skxmxm/handWritePen/hardware/rear_R26/warning_fit_review.md

# final23 装配件供应商属性告警独立复核

本报告只读核对 U201、D501、D502、D503。未修改嘉立创EDA、原理图或PCB。7 个 DNP 由主审另行核验。本报告不是全板 DRC 或订单批准。

**结论：上述 4 个 FIT 器件的型号、落板焊盘及 LED 极性可以得到证据支持，未发现需要重布线的封装不兼容。现存告警是库身份/属性偏差，不能表述为“原生告警已清零”。应规范器件身份和装配说明，或在发布记录中保留已核验偏差。**

## U201：ESP32-S3-MINI-1-N4R2 / C3013941

- PCB 实例型号和供应商号分别为 `ESP32-S3-MINI-1-N4R2`、`C3013941`；封装标题为 `BULETM-SMD_ESP32-S3-MINI-1-N8`。
- 本地原生公共库检索记录 `../research/module_search.json` 里，**N4R2/C3013941 本身就使用 N8 标题的封装**（公共库封装 UUID `688e78e9fb32474d8c79531d0a7cca14`，器件 UUID `41c06bb1f3f2465a9300afebb9173e5f`）。本地克隆器件映射见 `../research/mini1_device.json`。
- 乐鑫官方 `esp_mini.pdf` v1.7，§1.2/Table 1-1 明确 N8 与 N4R2 两版本仅 flash/PSRAM 配置不同。官方 §11.1/Figure 11-1（第45页）给出同一 MINI-1 推荐焊盘。因此 N8 封装名称本身并不表示装错物料。

| 焊盘项目 | 官方推荐 mm | final23 mm |
|---|---:|---:|
| 60 个外围长方形焊盘 | 0.4 × 0.8 | 0.39878 × 0.80010 |
| 四角 GND 方焊盘 | 0.8 × 0.8 | 0.80010 × 0.80010 |
| 中央 3×3 分区 GND 焊盘 | 每格 1.2 × 1.2 | 每格 1.19888 × 1.19888 |
| 中央 3×3 总跨距 | 4.5 | 4.50088 |
| 外围等距序列节距 | 0.85 | 0.84836 / 0.85090，受导出量化影响 |

实际共 73 块铜焊盘：60 个外围焊盘、4 个角部接地焊盘、中央接地端子分为9块；这与模块 65 个电气引脚并不矛盾。外围焊盘行存在约0.025 mm级与官方标注中心线的库几何差异，但落点仍在对应焊接端子区域，不属于型号 N8/N4R2 的差异。

官方 Table 3-1（第11–12页）特别规定：**N4R2 的 IO26（模块 pin 26）用于内部 PSRAM，禁止外用。** final23 的 pad 26 `eb0052c9b29dee77e102` 网络为空，未分配外部功能；不是 GPIO26 误接。USB pin23=IO19/D−、pin24=IO20/D+，当前分别接 `MCU_USB_DM` 和 `MCU_USB_DP`。

## D501–D503：LTST-C190KRKT / C94869

公共库原始检索缓存 `../../../archive/rear_ble_v0.2/led_candidate.json`（实际绝对路径见 JSON）独立确认：LITEON `LTST-C190KRKT` 对应 `C94869`，公共库器件 UUID `63e5f6cf97f041959d3d2be0d8ee7c02`。不要误选后缀 `-TH` / C284900。

实际实例属性已设为上述 Lite-On 型号，但底层器件名还保留 `19-217/R6C-AL1M2VY/3T`（Everlight）。这是真实的**库身份元数据不一致**，应整理；不能只因都是0603而笼统忽略。

使用精确型号的 Lite-On 官方 `LTST-C190KRKT.pdf`（DS-22-99-0151 Rev F，2013-05-16）进行几何核对：

| 焊盘项目 | 官方 PDF 第8页/印刷第7页 mm | final23 mm | 差值 mm |
|---|---:|---:|---:|
| 单焊盘宽×长 | 0.8 × 0.8 | 0.80010 × 0.80010 | +0.00010 |
| 两焊盘中心距 | 1.5（由2.3−0.8得到） | 1.49606 | −0.00394 |
| 两焊盘外缘总跨距 | 2.3 | 2.29616 | −0.00384 |
| 两焊盘内缘间隙 | 0.7（由2.3−2×0.8得到） | 0.69596 | −0.00404 |

上述约4 μm的量化差异不形成落板兼容问题。使用官方建议尺寸完成核验，而不是以通用封装名推断。

### 极性证据链

1. 官方 PDF 第2页/印刷第1页标注实物 `CATHODE` 端及极性，第8页/印刷第7页还标明卷带阴极方向。渲染证据 `warning_LED_p2.png`、`warning_LED_p8.png`。
2. 发布工程归档中 `SYMBOL/641f656535e2a0d7.esym` 的引脚属性明确：pin1 的 NAME=`C`，pin2 的 NAME=`A`。
3. 同一归档 `FOOTPRINT/4d57fd2c087faba9.efoo` 明确：pad1 在局部负X一侧，pad2 在局部正X一侧。该封装源 UUID `52397efb0c114c5ca131f1a452e65163` 是 Lite-On `-TH` 版本的通用 `LED0603-RD` 来源；此处已按**实际采购的无后缀型号**重新核验尺寸。
4. final23 三个器件均在顶层、rotation=0，映射如下。坐标单位 mm，为PCB数据坐标。

| 位号 | pin1/C 阴极网络 | pin2/A 阳极网络 | 阴极 X | 阳极 X |
|---|---|---|---:|---:|
| D501 | GND | LED_SYS_A | 34.25190 | 35.74796 |
| D502 | GND | LED_FAULT_A | 37.75202 | 39.24808 |
| D503 | CHG_STAT2 | LED_CHG_A | 41.25214 | 42.74820 |

因此，**顶视图三只 LED 都应阴极朝左（较小 X）、阳极朝右（较大 X）**。D503 阴极接充电芯片开漏状态 `CHG_STAT2`，由其下拉点亮。装配时以 Lite-On 数据手册标记和以上电气定义核对，不能仅凭继承的旧型号名字判断方向。

## 发布处理建议

- 可以保留已路由的焊盘几何。BOM 必须保持 U201=`ESP32-S3-MINI-1-N4R2/C3013941`；D501–503=`LTST-C190KRKT/C94869`。
- 首选清理器件库身份；若绑定标准库会改变焊盘坐标、编号或钢网开口，应保留经审核封装，并明确记录偏差，不应为消除标题告警盲目替换。
- LED 的 `Review` 目前仍含 `Engineering draft; MPN and footprint require review`，应更新为已核验记录，避免与发布结论矛盾。
- SMT 装配说明必须明确三个 LED 的阴极方向。CPL 数值角度还须由主审与厂家贴片坐标约定核对；不能仅由 rotation=0推断供料朝向。
- 若主审规范了元数据或重新绑定库，继续导出 BOM/CPL 并核对 pad identity、原理图网络、铜层/钢网；本报告不声称修改后检查已完成。

审查输入：`final23_pcb.json` SHA-256 `add49678d7fddc966dc4f3cfcc579124299e275c2b622c8afa2d397cdd9152c0`。结构化结果、完整证据路径见 `warning_fit_review.json`。
