skxmxm/handWritePen/hardware/rear_R26/下单与耗材说明.md

# R26 裸板＋钢网，自行焊接下单说明

> **同日降本补充：**下面9孔填孔盖帽参数是R26原文件的保守制造基线，不等于9孔都不可取消。逐孔复查为8处普通阻容＋1处无贴件测试焊盘；推荐局部移孔后改普通工艺，详见[盘中孔降本评估](盘中孔降本评估.md)。当前未改PCB，不应仅切换订单选项就把本包视为已验证的低成本版本。

更新：2026-10-12。用户选择不购买SMT代工，已有热风枪、烙铁和加热台。本说明仅改变采购与装配方式；在线PCB、板框、网络及R26 Gerber没有改动。未登录代下单、未上传工程、未购买任何物品。

## 先用哪些文件

- 嘉立创PCB下单上传 `后板_R26_制板文件.zip`，不要上传外面这个指南压缩包或旧PCB＋SMT全套包。
- 嘉立创钢网独立下单上传 `后板_R26_钢网原始层.zip`。包括原始GTP、GBP、板框、双面装配和丝印参考。真正开孔依据GTP/GBP，不能拿阻焊层GTS/GBS开钢网。
- `VIA_IN_PAD_PROCESS.csv` 是当前9个盘中孔的坐标清单，作为PCB备注附件。
- `BOM_FIT_REVIEW.csv` 是一块板112个实装器件的采购基线，不是向工厂提交SMT委托。表内“Automatic SMT”是历史装配分类，本次全部自行装配；U401/J301依然最后后焊。
- 8件DNP和3组PCB_ONLY按 `DNP_PCB_ONLY_REVIEW.csv` 排除，不按焊盘数量购物。

## 1. 下裸板订单

在[嘉立创官网](https://www.jlc.com/)进入PCB计价/下单，上传制板ZIP；也可在嘉立创EDA选择PCB下单入口。页面标题随版本可能变化，以以下工艺值为准。

| 项目 | 本板填写 |
|---|---|
| 服务 | PCB裸板，不选择SMT贴片、代购代贴 |
| 材料/层数 | FR4 / 4层 |
| 单片尺寸 | 70×24 mm |
| 成品厚度 | 1.00 mm，常规±10% |
| 数量 | 建议先做5片，实际按平台起订数和报价决定；先装1片验证 |
| 拼板 | 单片出货；本次手工装配先不另做拼板/工艺边 |
| 铜厚 | 外层1 oz、内层0.5 oz |
| 阻焊/丝印 | 绿色阻焊、白色丝印 |
| 表面处理 | 沉金ENIG |
| 叠层 | 指定JLC04101H-3313；不能默换7628 |
| 阻抗 | USB差分90 Ω±10%，L1参考L2 GND，主干W/S=0.15/0.15 mm |
| 盘中孔 | 指定9孔树脂填孔、整平、电镀盖帽；普通盖油/塞油不能替代 |
| 其它 | 保留8个PTH金属槽、3个NPTH孔；全板231个过孔 |

小板尺寸不能代替特殊工艺报价。四层、沉金、阻抗及填孔盖帽可能不适用普通免费打样活动，费用以网站和工程审核为准。如果页面只能整板处理过孔，可按全部231个过孔询价，8个连接器槽和3个非金属孔不得填堵。只需裸板也仍然需要这9处盘中孔工艺。

PCB备注可复制：

> R26手写笔后板，单片70×24 mm，四层FR4、1.00 mm，外层1 oz/内层0.5 oz，绿油白字、沉金。指定JLC04101H-3313，USB L1差分90 Ω±10%、L2 GND参考，主干线宽/线距0.15/0.15 mm。附件VIA_IN_PAD_PROCESS.csv的9个盘中孔要求树脂填孔、整平、电镀铜盖帽，器件焊盘开窗保持可焊；不能用盖油或塞油替代。保留8个金属化槽、3个NPTH孔。只制裸板，不委托SMT。J401引脚文字高0.85 mm，请工程确认能否完整清晰印刷；不能处理时请反馈工程稿，不要静默裁掉关键脚号。

**丝印需确认：**本次重新对照官网发现，J401五个引脚文字0.85 mm低于公开常规字符高度≥1 mm；标题为1 mm，普通位号1.1 mm。此前“丝印无重叠”的检查只证明间距，不等于符合所有印刷工艺要求。铜层、焊盘及网络不因此改变，但不能保证小字印刷质量。板厂若拒绝这一字高，应先单独修正丝印并重新导出，再提交生产，不能把旧版DRC=0当成厂方工艺确认。

注意：旧包《嘉立创工艺核实》中的13孔、223孔数字属于D3历史，当前必须用随包9孔CSV与231孔钻孔文件。

## 2. 单独开钢网

官方[钢网下单](https://www.jlc-gw.com/quote-online/steelmesh)可以独立下单，无须委托SMT。

| 项目 | 本次建议 |
|---|---|
| 类型 | SMT钢片（不带框），适合无印刷机的手工定位；若后续买印刷架，再按架子规格选带框 |
| 工艺/用途 | 激光切割、锡膏网；不选红胶网 |
| 面别 | 顶层和底层分开，2张，总计一套 |
| 厚度 | 顶面0.08 mm；底面0.10 mm |
| 抛光 | 电解抛光；纳米涂层可选，不是本次必需项 |
| 成品钢片长宽 | 选能容纳70×24 mm图形且四周留出刮刀行程/胶带固定区的规格；不能把成品钢片也做成70×24 mm。以平台可选尺寸和手工夹具匹配 |
| MARK | 无自动印刷机，可不增加MARK通孔；现有孔/外框辅助定位 |
| 工程稿 | 选择“需要确认PDF档”，核对后再切割 |
| 方向 | 文件是原始工程坐标，未预镜像。由钢网厂按实际印刷面处理底层方向；自己不再镜像一次 |

若网页的“顶底分开”只能填同一厚度，将顶面、底面各建一条钢片订单，并在备注写明同一R26板的TOP/BOTTOM。不要为省一个订单而默认两面0.12 mm。官方还支持顶底合开一张，若日后想用同一厚度合开，必须先重新确认最小孔脱模，不按当前推荐直接合并。

厚度建议来自原始锡膏层几何，不是随口选值：

| 位置 | 原始最小开口 | 0.12 mm面积比 | 0.10 mm面积比 | 0.08 mm面积比 |
|---|---|---:|---:|---:|
| 顶面U103，3个开口 | 约0.30×0.20 mm | 0.500 | 0.600 | 0.750 |
| 底面U101，10个引脚 | 约0.50×0.20 mm | 0.595 | 0.714 | 0.893 |

面积比=开口面积/(开口周长×钢片厚度)，约0.66是常用脱模筛查参考值，不能代替实际锡膏转印试验。旧文件的0.12 mm只是默认工厂评审输入，本次手工印刷建议以此表更新为顶0.08、底0.10。顶面薄钢片减少大焊盘锡膏体积，需钢网厂同时复核ESP32等大焊盘锡量及分窗；若要改开口，应提供工程PDF并说明变动，不自动整层缩孔。

钢网备注可复制：

> R26后板，单片70×24 mm，手工印刷。顶面0.08 mm、底面0.10 mm，两张无框锡膏钢片，激光切割、电解抛光。以GTP/GBP为原始锡膏层，不使用阻焊层生成；文件未预镜像，请按实际顶/底印刷方向制作并标TOP/BOTTOM。保留DNP和PCB_ONLY不开孔的现状。U101散热焊盘、ESP32模块底部焊盘按原有分窗作为审核基线；请复核脱模和锡量，任何缩孔/分窗调整先给PDF确认。U401 JY901S为后焊模块，其锡膏开口是预镀锡用途，不得因“非常规元件”而静默删除。请标R26/TOP/BOTTOM及厚度。

## 3. 在立创商城买哪些耗材

到[立创商城](https://www.szlcsc.com/)按下表关键词搜索即可。这里给采购规格，不冒充已查到库存/价格，也不随意指定未经核实的商品编号。

| 耗材 | 搜索词/规格 | 首批建议 |
|---|---|---|
| 锡膏 | SAC305 无铅锡膏 T4 小包装，正规品牌、有储存说明和回流曲线；手工刮印优先选适合钢网印刷的型号 | 10～20 g一份，细间距用T4 |
| 助焊剂 | 电子焊接用低残留助焊膏/助焊剂，兼容所选锡膏，可清洗 | 1支小包装 |
| 焊锡丝 | SAC305无铅焊锡丝，直径0.3～0.5 mm，用于接口和补焊 | 1小卷 |
| 吸锡带 | 1～1.5 mm细吸锡编织带 | 1卷 |
| 钢网刮刀 | 约80～100 mm有效刃宽、直边、适合小钢网 | 1把 |
| 清洗耗材 | 与助焊剂兼容的电子清洗剂；可用IPA的型号配高纯异丙醇、无尘布、无尘棉签、ESD刷 | 各1份 |
| 定位/遮挡 | 聚酰亚胺耐高温胶带、同厚度垫板或可调PCB定位夹具 | 各1份 |
| 拾取 | 精细防静电镊子，直头＋弯头 | 已有则不买 |
| 双面支撑 | 耐高温PCB边缘支架/悬空夹具；底下留出器件净空 | 1套，避免器件压在热台上 |
| 检查/测温 | 显微镜或足够倍率放大镜、K型细热电偶温度计 | 已有则不买；屏幕设定温度不等于焊点温度 |

本板底部焊盘/细间距不能靠普通烙铁逐脚完成。已有热风枪＋加热台可做预热与局部回流，但仍需控制实际温度、风量和焊点锡量。优先常规SAC305，不把138℃铋系低温锡膏当作可随意替换的省事方案；换合金会改变回流与机械可靠性，需另做工艺验证。

锡膏按产品说明冷藏、密封回温后开盖，查看有效期；不把统一的热风枪显示温度当成回流曲线。不使用水暖焊接酸性助焊剂。GSR模拟前端对残留敏感，补焊后按药剂说明局部清洁并干燥；不要给JY901S整模块浸泡或超声清洗。

## 4. 元器件与自焊顺序

耗材不包含器件。按BOM_FIT_REVIEW中的制造商料号和容差单独采购，默认一板112件，8个DNP不装。常用阻容多备一些；昂贵芯片按计划装板数外加适量备件。不要把库中Supplier Part字段一概视为立创有现货，尤其JY901S仍应按已选裸模块向原供应商采购。

必须保留ESP32-S3-MINI-1-N4R2、BQ25185DLHR、TPS63802DLAR、R111/R112的精度与温漂、正确LED料号；不能凭历史封装名或同阻值自动替料。前端PAT9125EL-TKIT仍购买成品，不下历史自制前板。

建议先装1块：底面细小器件先印刷/回流，检查短路；再将板固定在悬空夹具上装顶面。已焊底面不能与热台直接接触；对齐第二面钢网也需要避让底面器件的支撑。第二次加热要避免下侧焊点重新熔化导致掉件，尽量以底部适当预热配合顶部局部热风，并按实际测温/器件耐温控制。ESP32的底部地焊盘需要按钢网回流，不能只补四周可见边缘。

顶底回流完成后，最后安装U401 JY901S和J301指套插座。USB连接器的金属化壳脚槽按实际润湿状态补焊；用限流电源先测短路、3V45、充电/USB/主控通信，再接传感器。普通显微镜无法直接检查藏在芯片下面的焊点，一次外观检查不能保证隐藏焊点全部良好。

## 官方依据与本轮限制

2026-10-12读取：

- [嘉立创PCB工艺能力](https://www.jlc.com/portal/vtechnology.html)：字符常规高度≥1 mm、线宽≥0.1 mm、距露铜≥0.15 mm，以及盘中孔工艺范围。
- [嘉立创钢网下单页](https://www.jlc-gw.com/quote-online/steelmesh)：无框钢片、顶底合开/分开、锡膏网、电解抛光、工程PDF确认及底层镜像说明。页面建议≤0.5 mm间距选电解抛光。
- [嘉立创EDA PCB下单说明](https://prodocs.lceda.cn/cn/pcb/order-order-pcb/index.html)。

锡膏层原始文件完全未变；厚度几何核算详见《钢网厚度几何核对.json》。本说明没有确认商城即时库存或订单实际价格，也没有提交制造订单。J401小字印刷与钢网开口/锡量审核仍需在工程稿落实。
