skxmxm/handWritePen/hardware/rear_R26/关键布局复核与首件重点.md

# R26 关键布局复核与首件重点

## 已重查

- 电源：开关节点短宽直连，主要电容和功率地/控制地按实际铜连接复核；一般供电主干原线宽保留。USB_RAW、USB_5V与3V45冗余台阶已整理。
- 模拟：GSR_S重复小环路已去掉；高阻节点远离主开关区域。J302调试支路保留，其长度不应全算成主采样通路。
- USB：全程顶层，实际L2 GND覆盖全线宽；主干W/S=0.15/0.15 mm，指定3313叠层。不能用任意默认叠层替代。端部ESD/焊盘扇出与分支不是均匀传输线；本次未做眼图。
- RF/IMU：实际四铜层的9个禁区均无铜；天线悬出及组装约75 mm总包络未改变。
- 可装配性：全部112实装封装外形检查，无同侧重叠，最近外形间隙0.475 mm。原生deviceClearance=0意味着不能靠DRC证明这件事，故本轮另行计算。

## 保留折衷

C101至BQ25185输入约3.8 mm/2过孔，优于无输入去耦但不是理想贴脚；R111高端反馈从共享3V45支路取样，约8.759 mm/2过孔（以本包final_critical_paths_usb.json的最终中心线路径为准），不属于独立Kelvin。本轮保持关键电源器件、接口与板框，并只疏开周边器件时，没有用穿越其它焊盘或减少净距换取外观。未见原厂给出这些长度的硬性数值门槛，故列为首件关注项而非伪称已全部理想化。

电容地回流按实际连续铜和内层地判断，不能只用最近过孔的距离代替回流路径。供电最窄段和电池瞬态需要结合真实BLE负载验证，几何检查不等于负载阶跃仿真。

## 首件重点

按既有《上电验证与放行清单》进行：受控电源限流启动、3V45带载及BLE峰值瞬态、充电与NTC、USB烧录、AFE标准电阻校准和底噪、JY901S/PAT9125接口、装壳射频与续航。新电池的正式连续/脉冲电流能力仍待型号资料和实测确认。未下单。
