skxmxm/handWritePen/hardware/rear_R26/嘉立创工艺核实.md

# 嘉立创盘中孔工艺核实

查询日期：2026-10-05。仅查询官方公开资料，未上传工程、询价或下单；PCB电路及几何未改。

## 结论

嘉立创明确支持本板所需的 **过孔塞树脂＋电镀盖帽（盘中孔）**。四层板支持，官方指引注明收费；具体费用与交期以订单实时报价为准。不能继续把“厂商是否有此能力”列为未知阻碍。

| 对照项 | 嘉立创官方规则 | D3情况 |
|---|---|---|
| 工艺效果 | 树脂填平过孔后表面镀铜；盖帽铜厚≥10µm；开窗处可以焊接 | 符合原要求的填实、平整、可焊铜帽结构 |
| 支持孔径 | 0.15～0.55mm | 两类过孔钻孔约0.20828/0.210mm，范围内 |
| 外径与内径差 | 至少0.1mm，推荐≥0.15mm | 约0.24384/0.240mm，满足 |
| 盘中孔位置 | 位于焊盘中心或边上均属于盘中孔 | 13处孔口与器件开窗相交，适用 |
| 层数及厚度 | 四层收费；FR4公开厚度范围0.4～4.8mm，以系统选项为准 | 四层、候选1.0mm在公开能力范围内；具体组合及叠层仍按订单确认 |
| 指定加工范围 | 可标示哪些过孔塞住，或按孔径备注 | 可提供13孔坐标清单；不必假定只能全板223孔加工 |

上述网页没有明确给出IPC-4761 Type VII认证承诺或完整凹凸公差。原文档的“Type VII等效”是工艺结构描述，不能写成板厂已认证。

## 下单工艺说明

选择 **过孔塞树脂＋电镀盖帽**，不要用“过孔盖油”或“过孔塞油”替代。建议备注如下：

> 四层FR4后板，70×24mm，目标厚度1.0mm，沉金。附件VIA_IN_PAD_PROCESS.csv列出的13个过孔要求树脂填实、平整、电镀铜盖帽≥10µm，器件焊盘开窗处保持可焊；不得用盖油或半塞油替代。请在生产稿中确认这些孔按盘中孔加工，保留器件焊盘开窗。孔径以最终Gerber/钻孔为准。其余过孔是否同时处理及费用，以订单工艺确认为准。

如采用整板同孔径加工，必须保留8个金属化连接器槽和3个非金属定位孔，不能把它们塞住。下单生产稿需核对塞孔范围、阻焊和层叠；这是订单执行核对，不是厂商能力未知。

## 原D3差距与D4处理

官方FR4规则为字符高度≥1mm、笔画≥0.1mm、字符到露铜焊盘间隙≥0.15mm。D3用途文字主要0.8～0.9mm，部分脚号0.65～0.75mm；0.12mm笔画满足要求，但字高不足。D3原CAM仅做0.1mm开窗避让，零重叠不能证明满足0.15mm露铜间距。**D4已修正：保留122处文字的设计字高1.1mm、笔画0.12mm；全部丝印至开窗最小约0.1699mm，文字图形最小约0.2009mm，没有文字被裁切；12个位号转装配层并附定位图。** 这些是制造文件检查，实物印刷效果尚未测量。

## 官方来源

1. [嘉立创工艺能力](https://www.jlc.com/portal/vtechnology.html)：当前公开工艺、0.15～0.55mm孔径、铜帽≥10µm及字符规则。
2. [盘中孔设计指引及规则](https://www.jlc.com/portal/q33i38630.html)：2022-10-19，明确四层收费、焊盘边孔适用及孔盘尺寸。
3. [过孔五种加工方式](https://www.jlc.com/portal/server_guide_15544.html)：页面显示更新2026-09-30，说明树脂填平后表面镀铜及按孔位/孔径指定加工。

网页快照、提取文本、URL及SHA256保存在 [官方证据目录](via_process_evidence/sources.json)。公开工艺核实不替代电池、电源及首件功能验证。
