skxmxm/handWritePen/hardware/rear_R26/本版说明.md

# R26 底面布局与接口丝印优化版

2026-10-09。原在线工程已保存，70×24 mm、四层1.00 mm，ESP32-S3-MINI-1-N4R2 / BLE。本包用于首批PCB＋SMT工程样板，交厂DFM与贴装预览核对；未下单。

## 已完成

- 疏开接口区、状态电路及模拟区的11个底面器件，其中8件实装、3件DNP；移动1个BAT_DIV过孔。接口、板框、主控、原理图和电气网络保持。
- C302与U301本体间隙由0.30提高到0.50 mm；R301与R312焊盘间隙约0.163提高到0.362 mm。R503与C107本体间隙0.875→1.875 mm；R510与R502间隙1.05→2.10 mm。
- 局部走线按直线/45°重新组织，清理短碎段与两处保存时的近共线合并。新增1个盖油接地过孔和2条直线，接通新布局中的前端固定焊盘地铜。最终1664线、231过孔；不能将线段减少量等同于肉眼可见转弯减少量。
- J401 OPT和五条1 VDD / 2 SCL / 3 SDA / 4 MOT / 5 GND紧邻实际接口，按对应焊盘排列；旧远端表格已删除。55个底面位号全部保留，调整28个位置/方向。实验室名称保留。

## 同版验证

- 原生PCB DRC=0，实际四层Gerber的77个有名网全部单一连通，短路、断网、浮铜和缺失焊盘中心均为0。
- 418个焊盘铜/阻焊/适用锡膏通过；USB全程顶层、无信号孔、L2参考地覆盖全线宽；9处禁布区无铜侵入。
- 自由直角/锐角0；32个焊盘/过孔/真实分支交汇另行归类。保留合理的短直连与原始量化微斜线，不声称全板每个原始片段数学严格45°。
- 112件实装外形无同面重叠，最小间隙0.475 mm；跨器件焊盘无重叠，最小间距0.21717 mm。
- 126条文字、158个内嵌封装丝印、POLY/FILL完整本体检查无冲突。实际丝印到开窗最小间隙顶面0.171978 mm、底面0.171984 mm；未经CAM裁切。
- 5页原理图电路记录不变，65符号/38封装齐全；38封装与R25逐字节相同。原生/API/EPRO中1664线、231孔、123器件逐对象一致。182个网络/层的铜形与批准候选按2 nm保存精度一致，无例外。
- 110件SMT和112件总装CPL各更新8件实装位置/方向，3件DNP的位置在工程与变更表中记录；BOM不变。全部现版CPL重新逐项核对。

## 制造与实物验证

保持指定3313叠层、USB 90Ω±10%、9处盘中孔树脂填孔/整平/电镀盖帽；新增GND孔为盖油孔，未增加盘中孔数量。110件SMT＋U401/J301共2件回流后手焊。

C101输入去耦跨层、R111共享电源支路取样等既有折衷仍列在《关键布局复核与首件重点》。本轮是设计与制造数据检查，首件上电、充电、BLE峰值、AFE噪声、真实电池续航及装壳适配仍需实测。

## 文件

- Rear_ESP32S3_R26.epro：完整可编辑原理图和PCB工程。只制造Rear_Mainboard，历史Front_Optical不制造。
- 后板_R26_制板文件.zip：18个原生文件，只剔除已证明重复的via-only钻孔文件。
- cam_top.png / cam_bottom.png：实际制造图；final_bottom_before_after.png为实际底面前后对照。
- R26装配说明.md和本版CPL为现行位置；旧R23 PDF仅用于器件识别和工序参考。
- R26本次核验为当前证据；R23/R24目录为历史依据。MANIFEST_SHA256.json核对文件完整性。
