skxmxm/handWritePen/software/PenLive/验证记录.md

# v0.61 启动灯光验证记录

2026-11-05。用户确认纯电池失败状态短按RESET可恢复；本版加入启动阶段显示，没有证明冷启动故障已修复。

- **实际Arduino编译通过**：本机3.2.1-cn板包，ESP32S3 Dev Module、Hardware CDC/JTAG、4MB、QSPI PSRAM、Huge APP；程序970,946字节，静态RAM49,292字节。日志 `reports/arduino_compile_v061.log`。
- **新增启动状态机C++测试通过**：初始化未完成保持双灯常亮；完成后灭250ms/亮250ms，同步10周期、逻辑计时5,000ms；正常灯态不抢占启动灯；结束后正确交还SYS/FAULT；32位毫秒回绕正确。日志 `reports/startup_lights_test.log`。物理闪烁的调度误差未实测。
- **底层API核对**：本机Arduino-ESP32 3.2.1-cn的esp32-hal-gpio.c要求pinMode注册后才能digitalWrite，已改为预置锁存→pinMode→digitalWrite。没有将此问题作为冷启动原因的已确认结论。
- **并发/激励核对**：setup先点亮两灯；任务只提交正常灯态，由主循环独占运行时LED输出。两个采集服务完成首轮结果后才闪灯；闪烁结束才广播/允许订阅；启动阶段GSR保持关闭，USB联锁、门限和状态机未改。
- **范围与兼容**：现有Python源文件及固件既有头文件共33份与v0.60哈希一致，新增StartupLights.h。v4传输协议不变，v0.60上位机可继续用；本轮无需重复UI/吞吐测试，下方80项Python等为v0.60历史结果。源文件比对和本轮验证摘要见 `reports/startup_validation_v061.json`。

闪灯表示应用的初始化流程已完成首次处理，不代表每个传感器健康。缺失传感器会在进入正常模式后通过FAULT及上位机反馈。队列/任务创建失败时SYS灭、FAULT常亮，激励关闭。若应用之前就卡在供电、ROM或复位阶段，软件无法点灯；本版没有自动重启或绕过保护。

本轮未烧录、未实物测试LED、首次电池启动或供电波形。交付前核验ZIP的CRC、文件内容、哈希与启动脚本执行权限；v0.60完整包已归档。当前源码/文档版本见 `reports/release_sha256.json`，本次压缩包校验在output目录的 `手写笔_R26_BLE_v061_包校验.json`。

---

以下为v0.60历史验证，性能、窗口截图和测试次数均对应那一版；本版仅通过上述未改文件核对复用兼容性结论。

# v0.60 验证记录

日期：2026-11-05。用户报告换板后恢复正常；怀疑电容损坏，未独立确认。此次是软件升级，不把换板反馈当作新版本实测。

## 已完成

- **Arduino实编译通过**：ESP32核心3.2.1、ESP32S3 Dev Module、4MB、QSPI PSRAM、Huge APP、Hardware CDC/JTAG。程序970,542字节，静态RAM49,284字节。日志 `reports/arduino_compile.log`；未上传。
- **80项Python测试通过**：v2/v3兼容、v4持续GSR/姿态、USB暂停、分通道时间与序号、抬笔/落笔/丢包缺口、超时/重启、CRC/所有分片长度、BLE订阅失败/队列溢出、原始与滤波切换、频率统计。日志 `reports/python_tests.log`。
- **5组C++本地测试通过**：位置累积、激励门控、ADS1115转换对、JY901S解析、电池窗口。激励状态机覆盖连续请求、USB/取消请求、上下界、ADC错误、超时和毫秒计数回绕。日志 `reports/native_tests.log`。
- **C++→Python光学协议核对通过**：真实打包结构生成3点样本，包含32位序号回绕、64位时间、负坐标和松开标志；由Python解码核验。`reports/cpp_optical.hex`。旧协议fixture保留用于兼容回归。
- **5组真实Tk功能检查通过**：三窗口联动、新v4双通道/滤波/USB暂停/独立清空、旧v3抬笔移动、增量渲染、旧无激励模式兼容。包括按钮、剪贴板、画布缺口和窗口内控件布局。`reports/gui_tests.log`。

## 模拟吞吐与界面结果

5秒本机模拟：200Hz轨迹点、50批/秒、25Hz遥测，经过真实协议解码、后台生产者、事件队列、实际Tk绘图，预载18,000个历史点。窗口预热500ms后测量。启用默认轻度平滑。

| 指标 | 本次测量 |
|---|---:|
| 设备计数推算的模拟采集率 | 200.0 Hz |
| 轨迹接收 | 200.0 点/秒 |
| 主遥测接收 | 25.0 包/秒 |
| 应用数据吞吐 | 8524.81 B/s |
| 界面调度 | 59.88 次/秒 |
| 队列等待P95 | 21.24 ms |
| 队列等待最大 | 28.76 ms |
| 接收点 / 产生点 | 1000 / 1000 |
| 序号缺口 / 过期丢弃 / 剩余队列 | 0 / 0 / 0 |

这是合成数据通过桌面软件的结果，**未测试真实BLE射频、传感器200Hz能力、人体GSR、实物延迟或显示器VSYNC**。具体结果见 `reports/continuous_refresh.json`，脚本可复现。调整期间发现每帧强制 `update_idletasks` 会将本机UI降至约30次/秒，取消后恢复约60；并发窗口启动未预热的一次试跑发生过期丢弃，未作为性能合格结果，最终测试明确预热范围。负载过重或后台运行仍可能降低频率，程序保留丢弃计数。

## 平滑边界

采用确定随机种子的1000点合成静止噪声，轻度模式RMS小于原始55%；1000计数/秒合成匀速段延迟小于7计数（约7ms），拐角不越过输入坐标包络，松开端点回到原始值，断笔后滤波状态重置。这些是算法测试，不是传感器实测降噪百分比。关闭平滑时保持输入点一致。

## 待实板验证

需要用户同时烧录固件、启动配套Python：确认电池供电＋BLE连接但不按微动时GSR/姿态持续显示，USB接入暂停激励；检查界面实测采集/接收/丢弃数、连续写字、长时间运行及续航。JY901S输出率/波特率由实际模块设置决定，本次未写入模块配置。ADC A0/A1非同时采样；统一软件时间戳不等于已验证物理同步。

截图 `reports/v060_window_0_模拟.png`、`v060_window_1_模拟.png`、`v060_window_2_模拟.png` 来自本版本实际窗口，模拟抬笔状态且持续姿态/GSR。文件哈希在 `reports/release_sha256.json`，包校验另见output目录。旧验证记录归档于 `reports/history/截至v059的验证记录.md`，不代表当前版本默认行为。
