skxmxm/handWritePen/hardware/rear_R26/原理图警告处理.md

# R23 原理图警告与日志处理

原生严格原理图检查：**0 error、1 warning**；PCB严格DRC为0。这里记录保留的已审核工程偏差，不把软件告警说成清零。

原先另一条警告来自后板图页4中已禁用BOM/PCB转换的PAT9125参考器件U1，8脚完全悬空。已备份后删除该参考对象，改为“采购光学模块经J401接入”的文字。后板418焊盘与新导出网表仍全部一致，独立前板历史工程未动。

保留提醒为“元件的属性与供应商编号不匹配”，涉及11个位号：

|位号|已核对的原因与处理|
|---|---|
|C104、R105、R319、R408、R409、R410、C405|7个DNP使用NO_PASTE自定义封装；铜/孔几何与原库完全保持，原生钢网无开口。保留自定义库，不能自动标准化恢复锡膏。|
|U201|C3013941明确为ESP32-S3-MINI-1-N4R2；供应商库本身沿用N8封装名。焊盘兼容，内部PSRAM占用的IO26未外用。采购必须N4R2。|
|D501/D502/D503|精确物料为Lite-On LTST-C190KRKT/C94869；旧底层器件名及Review字段来自Everlight工程草稿。已按Lite-On原厂推荐焊盘与阴极标记重新核验；将该元数据差异作为有记录的偏差接受。旧Review字段由本报告覆盖，不作为采购或待审状态依据。|

**三只LED顶视图均阴极朝左（较小X，pad1），阳极朝右（pad2）**。机器供料角度在工厂贴装预览中核对。不得按继承的Everlight名字或-TH后缀替换BOM。当前制造BOM/CPL采用精确料号、位置、面和转角，没有按旧底层名称采购。

证据：`warning_fit_review.md/.json`、`final23_schematic_disposition.json`、`final23_netlist_check.json`及418焊盘/原生导出验证。这个有记录的库偏差不要求重新布线；若以后重绑标准器件库，应重新核对编号、铜、钢网和BOM/CPL。

截图中的6条“格式错误”位于应用日志，最晚为2026-10-07 20:04:45；各条没有具体对象或失败操作，历史触发原因不能仅凭文字确定。最新保存、工程/网表导出未新增此错误，当前EPRO/在线源/418焊盘/实际CAM已交叉核对。原日志保留，没有清空日志来制造零错表象。记录见`final23_log_review.json`。

交付状态限定为**首批工程样板的PCB＋SMT文件**；厂方DFM、备料与机台预览按工艺说明核对，实物上电、真实电池适配和整机性能仍按首件清单实测。未下单。
