skxmxm/handWritePen/hardware/rear_R26/盘中孔降本评估.md

# 盘中孔工艺降本复核

2026-10-12。只评估，不改变PCB、Gerber或下单。

## 修正先前结论

R26旧制造基线把所有与器件/测试焊盘阻焊开窗相交的9个过孔统一列为填孔盖帽对象。这是一种保守制造选择，不能直接推导成“全部9孔在任何装配方式下都必须做这个工艺”。此前回复表述过强。

逐孔核对发现：

| 位置 | 装配用途 | 降本考虑 |
|---|---|---|
| R113.1、R505.2、R102.2、R109.2 | 实装电阻焊盘 | 优先移出焊盘并补短走线；原位开孔手焊可尝试，但有吸锡/焊点不均风险 |
| C206.2、C107.1、C106.1、C105.1 | 实装电容焊盘，其中两孔在边缘部分相交 | 优先局部移孔；电源电容处须保持低阻抗、短回路及跨层连接，不能随意远移或删孔 |
| J302.3 / GSR_S | PCB_ONLY测试焊盘，不贴器件、无锡膏 | 通常无需填孔盖帽；按探针/焊飞线用途确认是否需要平面接触 |

这些孔不是隐藏于BQ25185/TPS63802等细间距IC底部的焊盘孔。普通阻容焊盘上的开孔并不必然导致整板失败，但焊锡可能流入孔中，造成锡量不足、两端不平衡及补焊；不能将这种人工可补救的试验装配等同已验证的量产工艺。

## 可选路线

1. **推荐：局部改版消除贴装盘中孔。** 保持电路功能，目标保持现有板框和接口位置，移出8个实装焊盘里的孔、局部重布线，并检查焊盘与孔间阻焊隔离、全层间距、回流、连通、钢网和丝印。确认普通过孔工艺适用后再导出新的制造版本。此时可用普通过孔盖油/符合板厂规则的塞油，省去树脂填孔盖帽。本次尚未完成移孔可行性和走线验证，不能把R26原包直接当成降本版。
2. **原位开孔做手焊试验。** 对这些普通阻容而言不是绝对不可焊，但需要逐处检查/补焊；开窗本身不阻止吸锡，全板统一开窗还会额外露铜。不是争取低返工率的首选，不作为未经首件验证的默认替代。
3. **直接改塞油并不等价。** 普通阻焊油墨不是可焊铜帽；在焊盘开窗内可能只能部分塞孔，也可能占去可焊表面。不得允许工厂为塞油整块遮住元件焊盘，必须看生产稿。所谓“选了塞油”不能保证原有盘中孔被填平且可焊。

电镀盖帽是局部焊盘孔的工艺需求，不是ESP32主控的固定要求。低成本方向应先优化孔位，而不是依赖未经验证的下单选项替换。

依据：[嘉立创过孔五种加工方式](https://www.jlc.com/portal/server_guide_15544.html)（项目已保存的官方资料说明：部分孔在开窗焊盘上时，塞油可能只能半塞；塞油表面不沾锡，树脂填平后镀铜才恢复可焊表面）。逐孔数据见《盘中孔成本复核.json》。历史9孔CSV保留作为R26原始基线，不代表推荐继续购买高价9孔工艺。
