skxmxm/handWritePen/hardware/rear_R26/cam_bottom.png

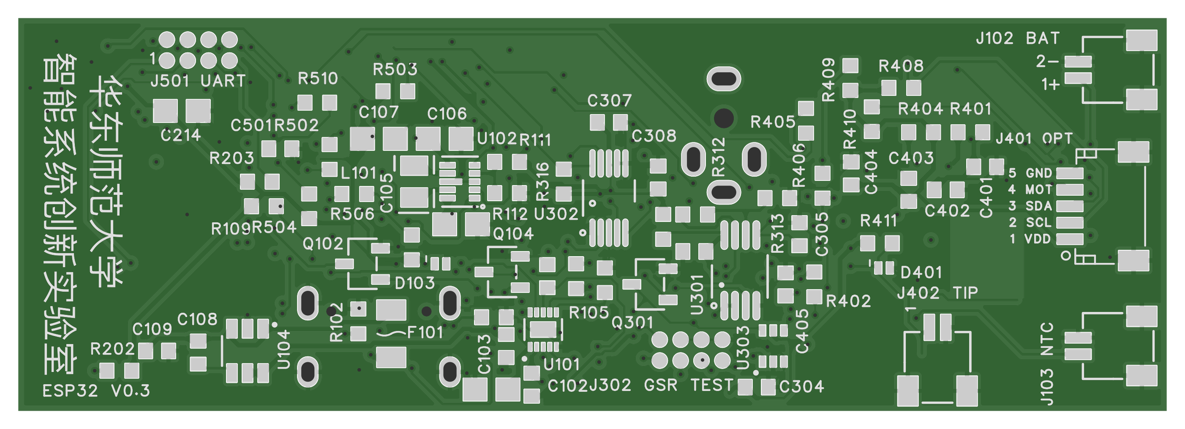
hardware/rear_R26/cam_bottom.png
