skxmxm/handWritePen/hardware/rear_R26/cam_top.png

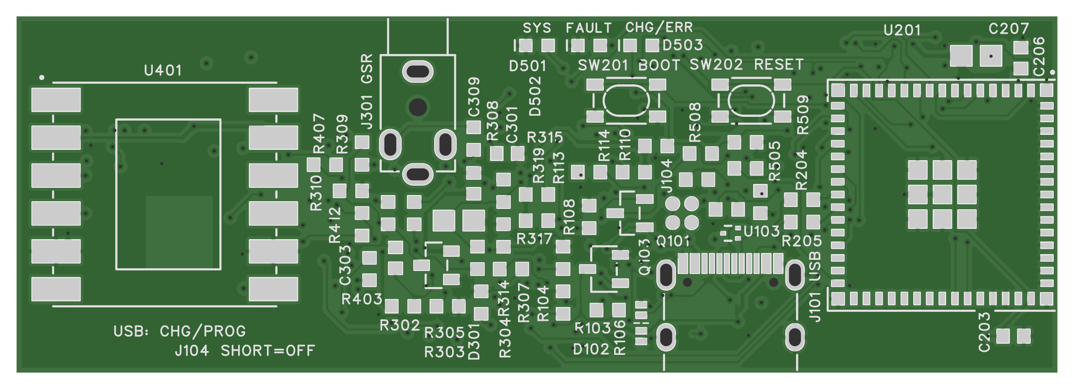
hardware/rear_R26/cam_top.png
