skxmxm/handWritePen/mechanical/v0.5/previews/exploded.png

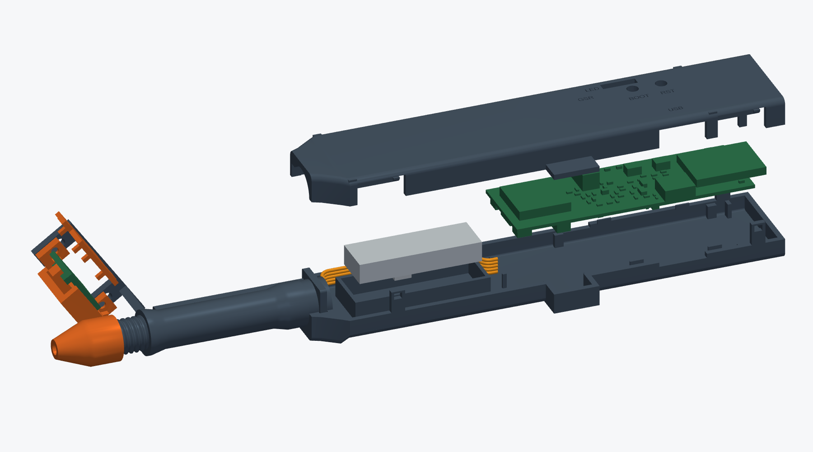
mechanical/v0.5/previews/exploded.png
