skxmxm/handWritePen/mechanical/v0.5/previews/hardware.png

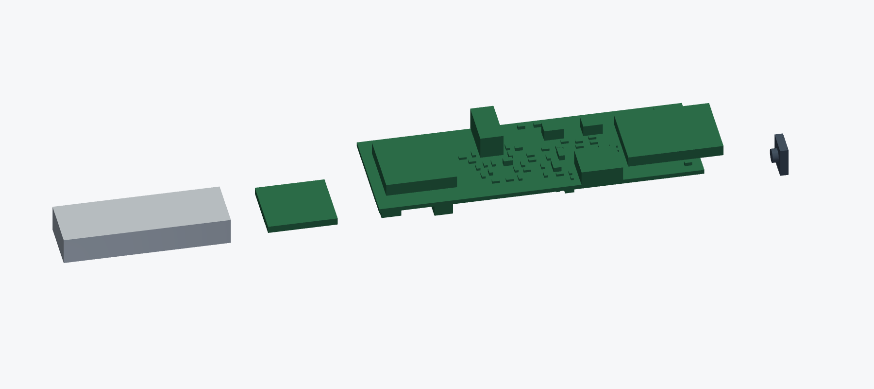
mechanical/v0.5/previews/hardware.png
