skxmxm/handWritePen/references/pcb_selection/previews/sj1_2503a_p2.png

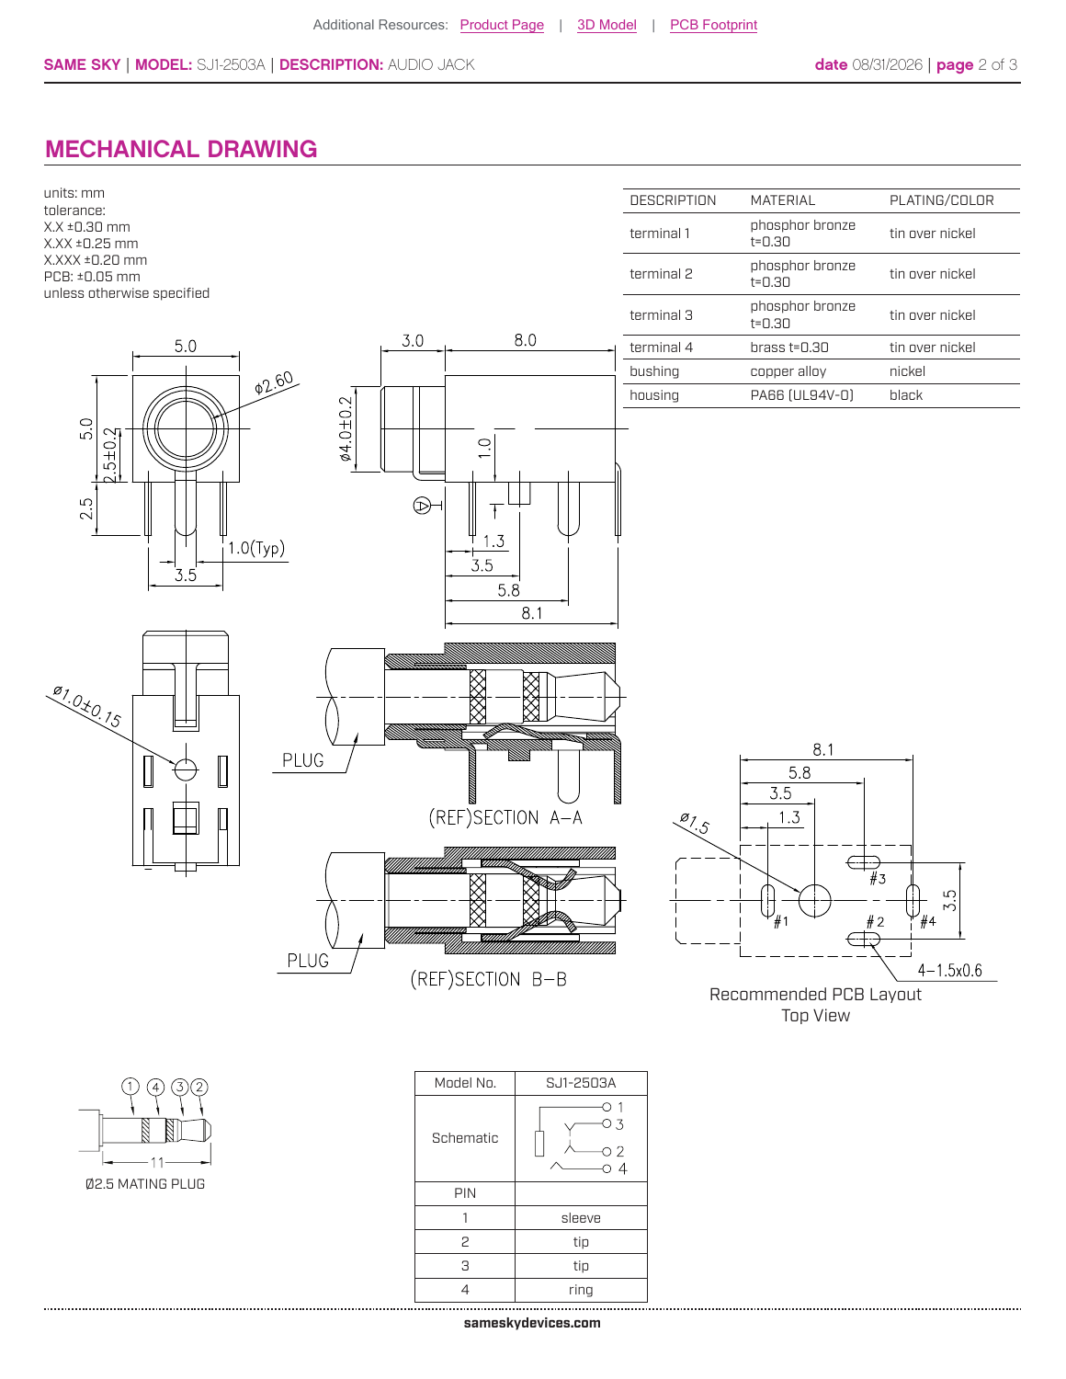
references/pcb_selection/previews/sj1_2503a_p2.png
