skxmxm/handWritePen/software/PenLive/reports/v060_window_1_模拟.png

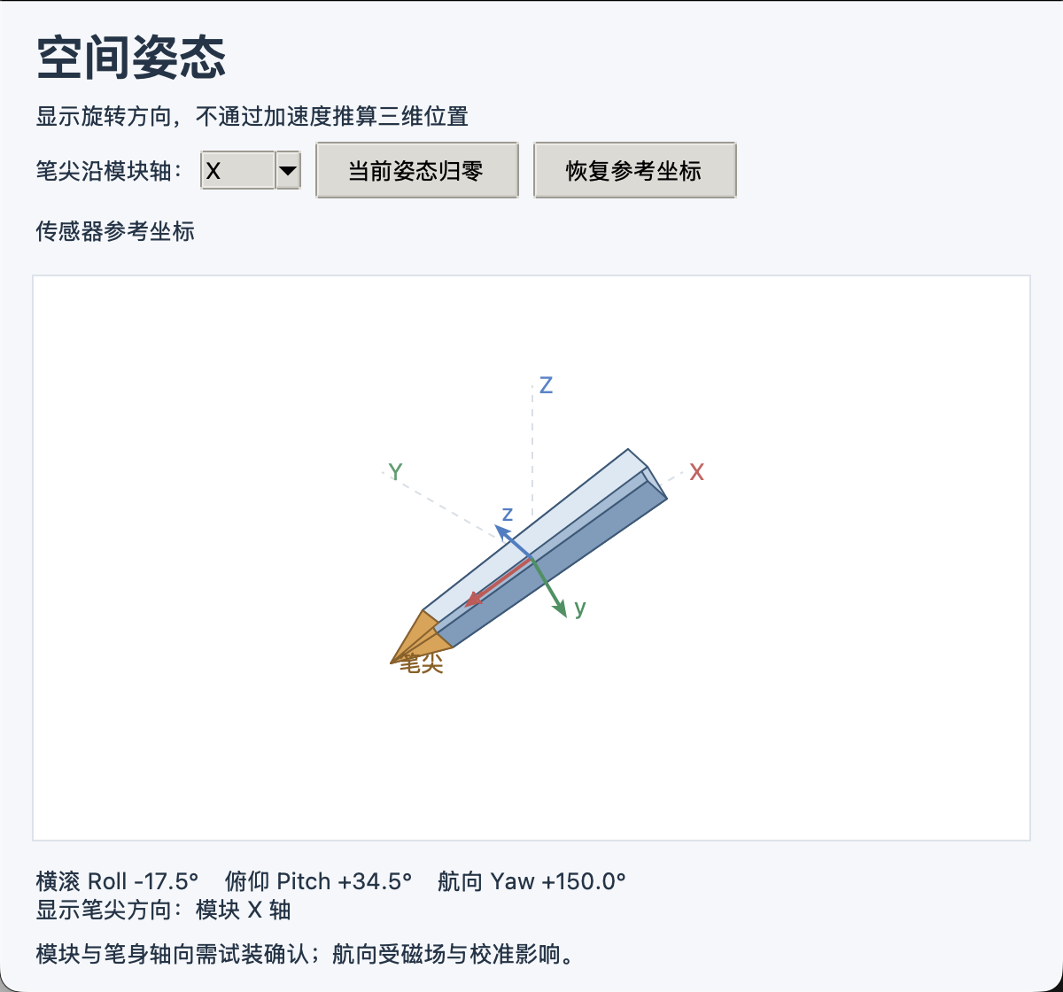
software/PenLive/reports/v060_window_1_模拟.png
