skxmxm/handWritePen/software/PenLive/reports/v060_window_2_模拟.png

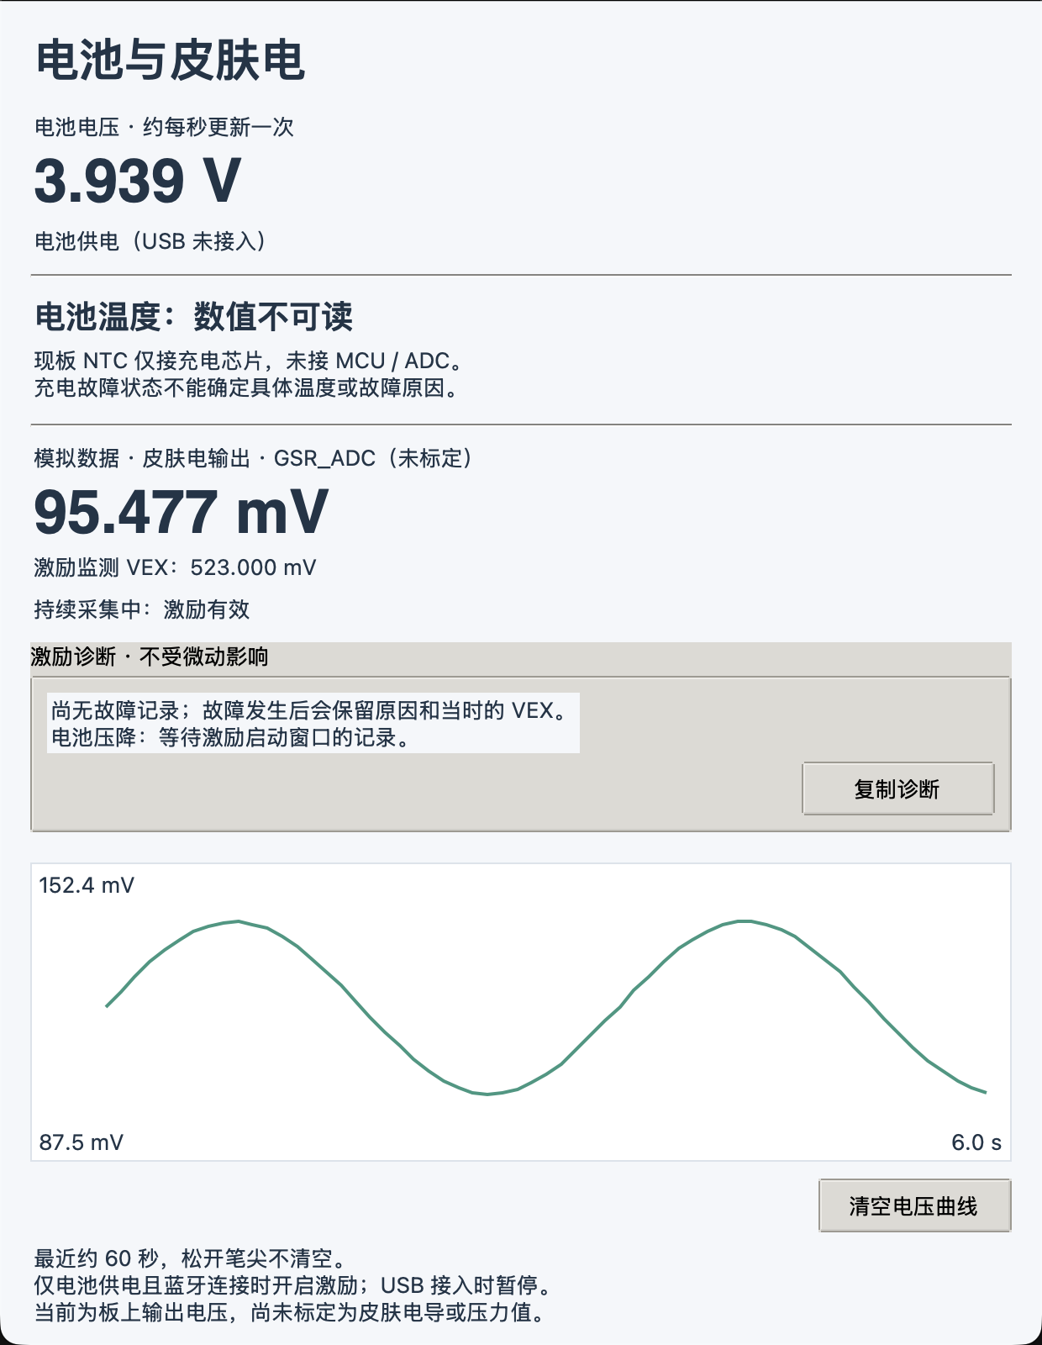
software/PenLive/reports/v060_window_2_模拟.png
