skxmxm/handWritePen/software/PenLive/reports/window_0.png

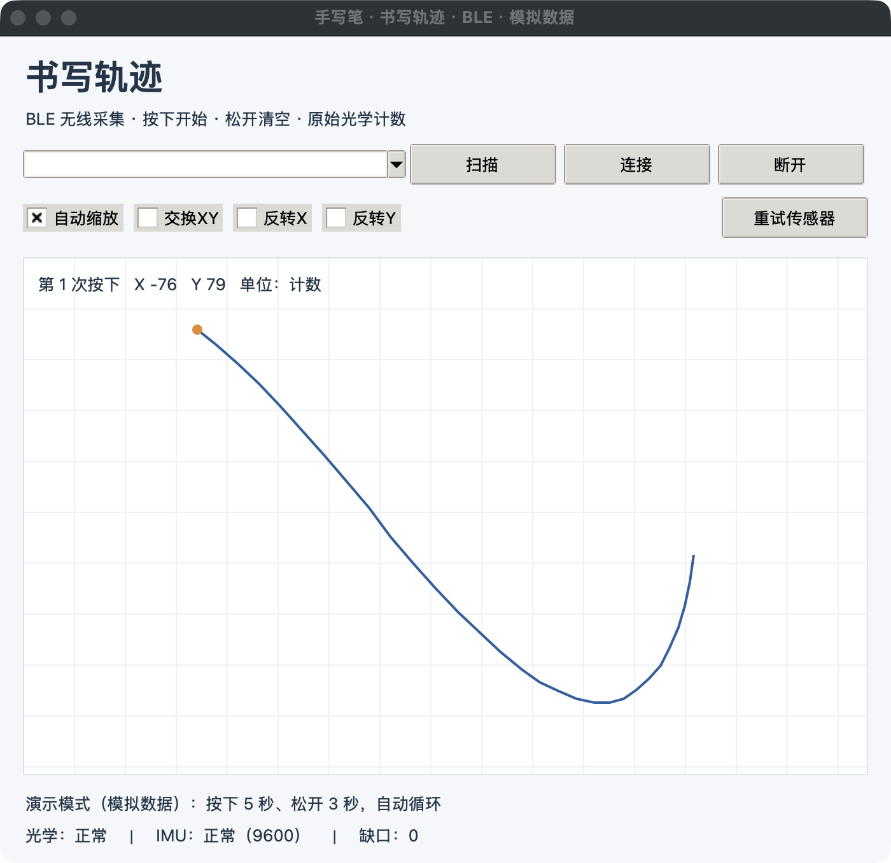
software/PenLive/reports/window_0.png
