skxmxm/handWritePen/software/PenLive/reports/window_1.png

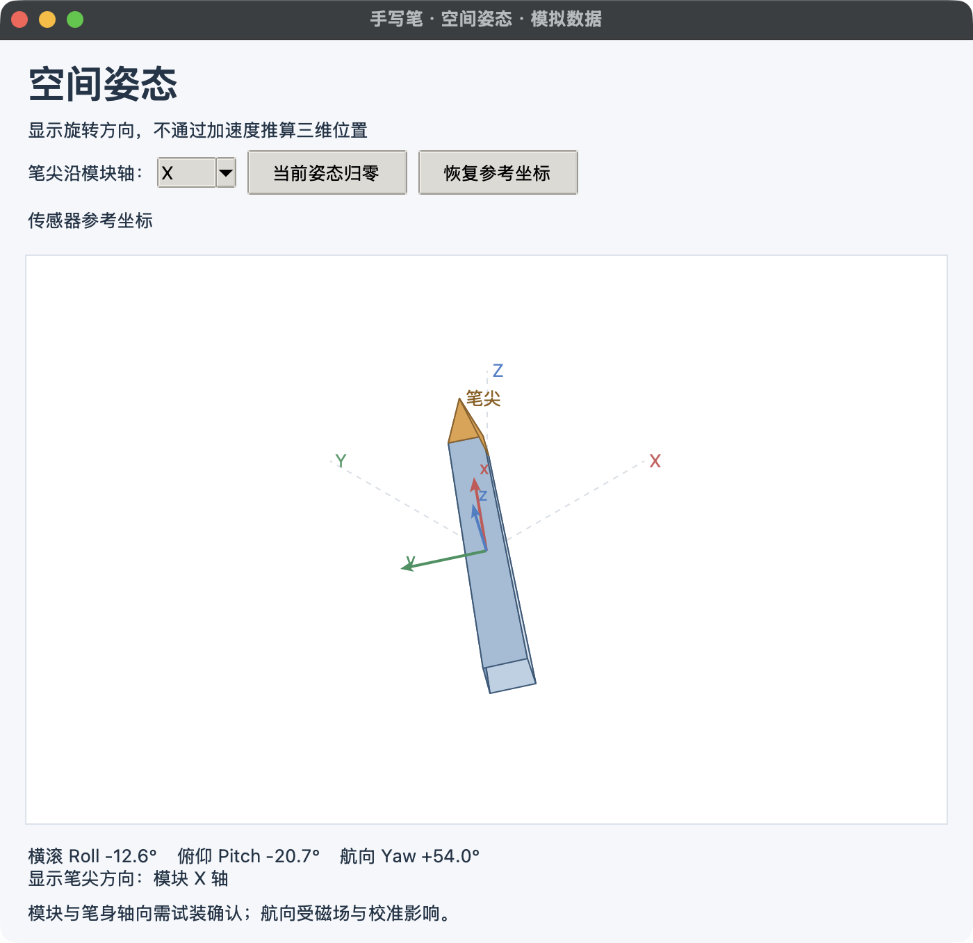
software/PenLive/reports/window_1.png
