skxmxm/handWritePen/software/PenLive/reports/window_2.png

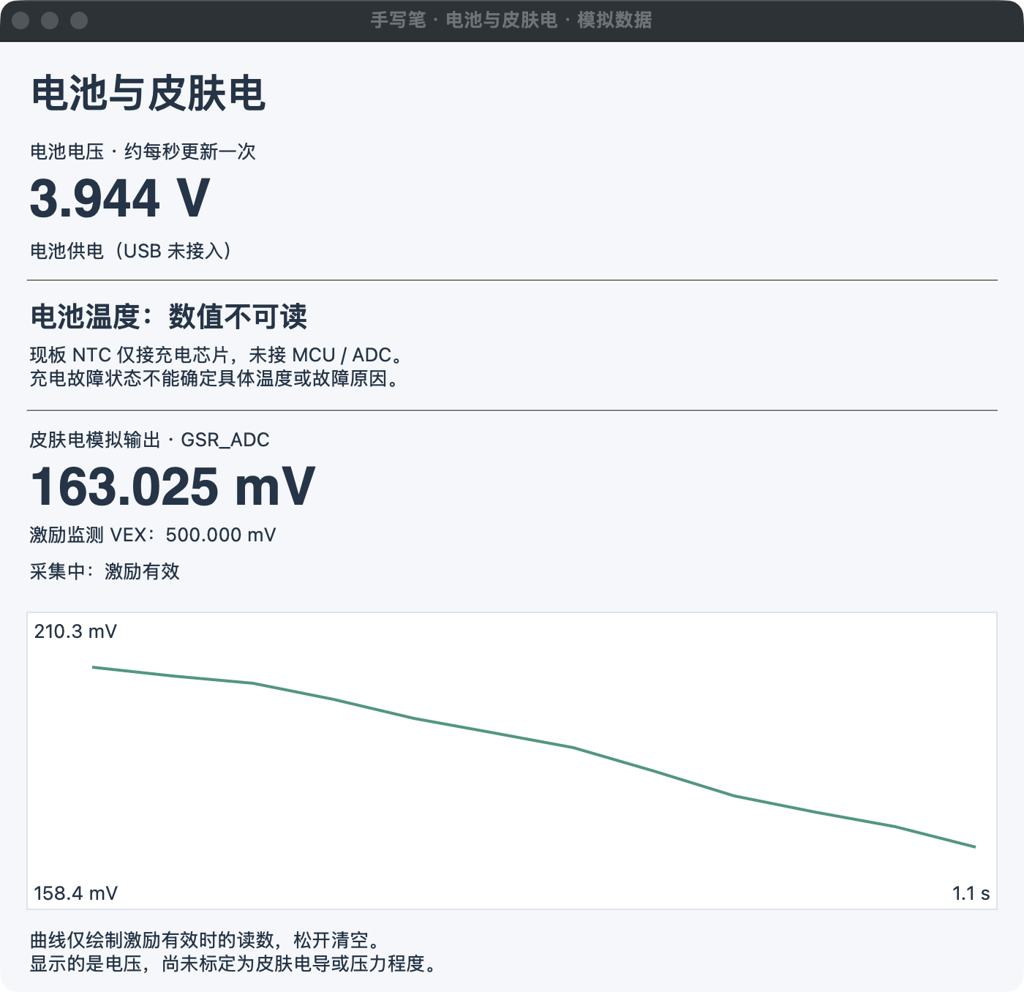
software/PenLive/reports/window_2.png
