skxmxm/handWritePen/software/PenLive/reports/无激励观察界面_模拟.png

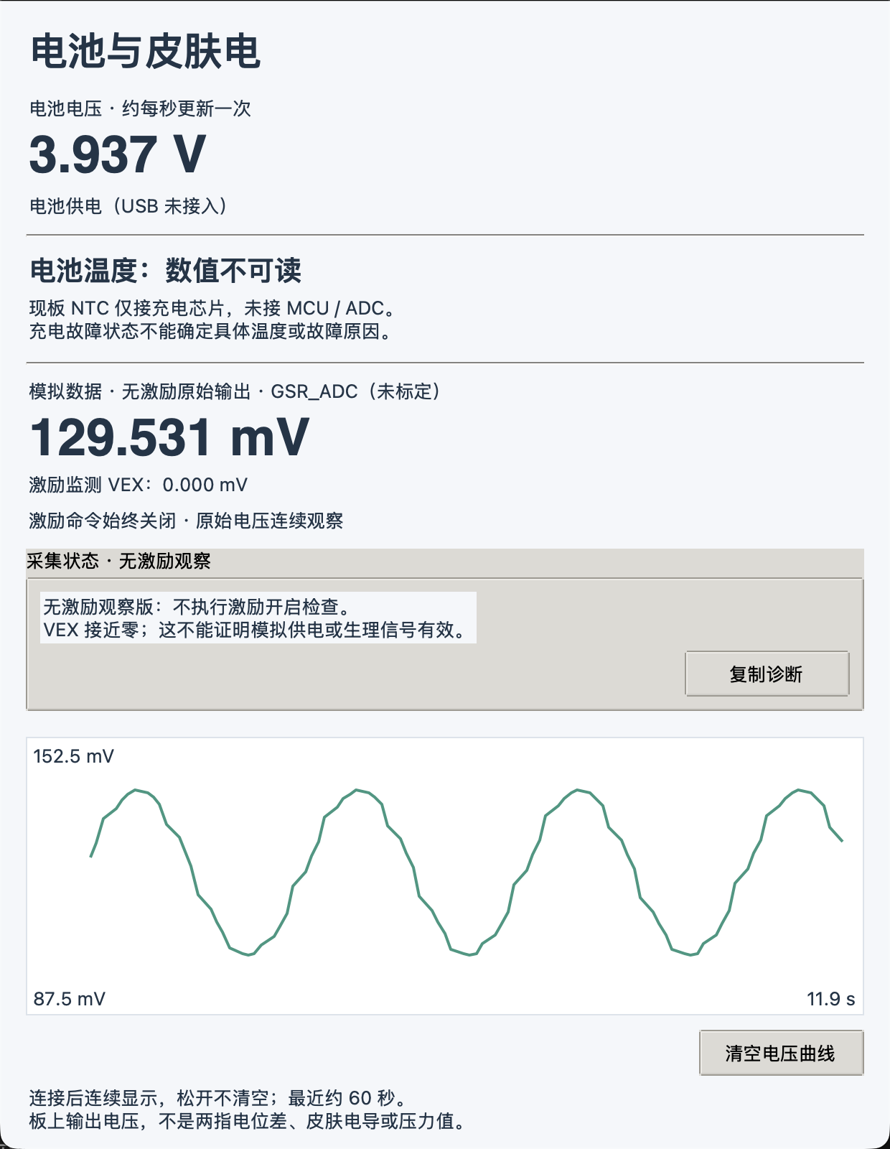
software/PenLive/reports/无激励观察界面_模拟.png
