skxmxm/handWritePen/software/PenLive/reports/界面演示.png

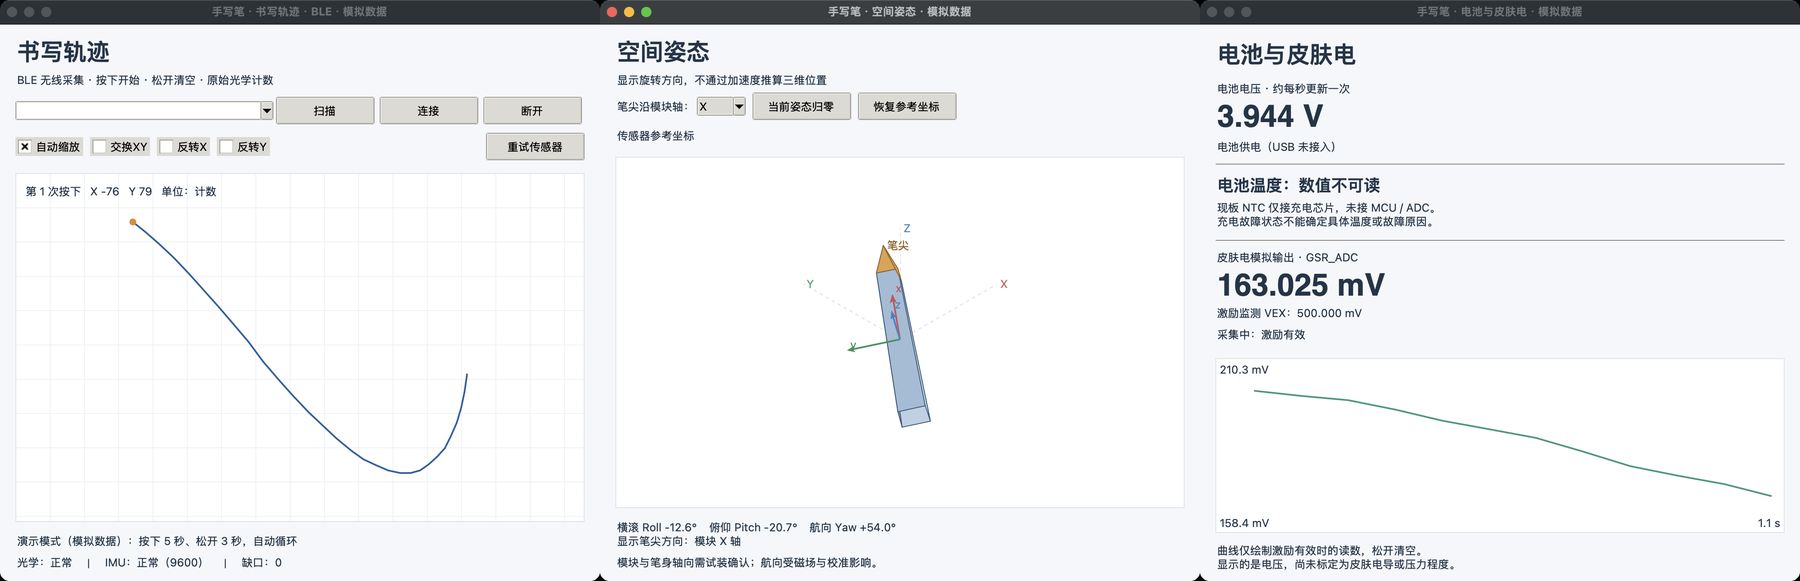
software/PenLive/reports/界面演示.png
