skxmxm/handWritePen/hardware/补件采购清单_R26.md

# R26 补件采购清单

> **2026-10-29 机械更新：**已交付[机械v0.5](../mechanical/v0.5/打印与装配说明.md)，适配36×12×6 mm新电池、EVQQ2B03W和现有五芯线（单根外皮外径按≤1.0 mm预留）。下文关于旧v0.4方槽不适配、细线转接及“尚未修改打印模型”的记录保留为历史；当前以v0.5装配说明为准。未修改后板或充电设置，未下单。

> **最新决定（2026-10-29）：用户不再购买光学段细线，改为评估外壳适配现有5P成品尾线。光学AWG32细线、C7496792取线组件均从当前必购清单取消；下文细线转接保留为历史备选。现有v0.4打印文件尚未更新，不能把该决定当作旧壳已能容纳粗线。**

查询日期：2026-10-29。适用 ESP32-S3 / BLE、五针 J401 的 R26 后板。仅做选品和接线说明，未下单，未修改 PCB、制造文件或外壳。

## 1. 用户截图里的尾线怎么选

商品标注“适用于 SHR-02V～12V-S-B 插头线”。按标称属于所需 SH 系列；下单规格应明确 **1.0 mm 间距、带胶壳及已压接端子、单头镀锡线**。兼容品的实际插合质量仍以到货为准。

| 页面选项 | 长度 | 一支笔用量 | 建议备料量 | 用途 |
|---|---:|---:|---:|---|
| **2P适用单头渡锡线** | **0.1 m** | 3 根 | **5 根** | J102 电池、J103 温度探头、J402 笔尖开关，各一根 |
| **5P适用单头渡锡线** | **0.2 m** | 1 根 | **2 根** | J401 光学模块；先调试，装壳时按下面的细线方案转接 |

“渡锡”是该页面的用词，实际是裸线端镀锡。单头：一端插后板，另一端焊器件；本方案不需要双头同向／双头反向。

JST 原厂 `-B` 表示带两侧拔插凸缘，针距和配合接口不变。原厂 2P 胶壳带凸缘宽 5 mm、不带凸缘宽 3 mm；5P 分别为 8 mm、6 mm。紧凑壳内不带凸缘更省空间，带凸缘版本到货后检查是否顶到邻件或壳壁，不强塞。

**截图标注 0.08 mm²，约为 AWG28，这是导体截面积，不是带皮外径。**2P 电气用途可用；5P 可用于桌面调试，但不能据此认定能穿前筒。现有前筒走线槽约厚 0.5 × 宽 2.4 mm，五根线需要薄而细，见第 3 节。

## 2. 立创可查询到的具体商品

优先成品尾线，不要求自己压接 SH 小端子。下面是可采购候选的具体货号；若已经购买上面的淘宝尾线，不要重复买同用途尾线。

| 物品 | 品牌／完整型号 | 立创货号及链接 | 一支笔需求 | 本次读取的境内库存 | 说明 |
|---|---|---|---:|---:|---|
| 2P 成品单头尾线 | 韩下 HX 1.0-2P DT 200mm 28AWG | [C47018648](https://item.szlcsc.com/49200433.html) | 3 根 | 895 | 1 mm SH 型胶壳，200 mm，UL1571 AWG28；另一端已剥皮镀锡，可剪短 |
| 5P 成品单头尾线 | 韩下 HX 1.0-5P DT 200mm 28AWG | [C47018651](https://item.szlcsc.com/49200436.html) | 1 根 | 320 | 与上项同系列；光学前筒段另转接细线 |
| 光学穿槽段的细线来源 | XFCN 兴飞 7.0024 | [C7496792](https://item.szlcsc.com/8563121.html) | 1 条 | 789 | 商品为 8 芯、300 mm、UL10064 AWG32，参数标单线外径 **0.38 mm**；剪掉两端插头，取其中 5 根作光学细线 |
| 笔尖常开开关，首轮验证选型 | Panasonic 松下 EVQQ2B03W | [C79178](https://item.szlcsc.com/80315.html) | 1 只，建议备 5 只 | 9345 | 0.5 N，短行程；需要适配 05/06 托架和 07 顶杆，详见下节 |
| 小型引线 NTC 候选 | SURGING 绍鑫 MF52B103F3435L100 | [C5439718](https://item.szlcsc.com/6318536.html) | 1 只 | 3690 | 10kΩ±1%，**B25/85=3435 K±1%**，100 mm 引线；本体最大约 Ø1.8×5 mm，需焊接到 2P 尾线 |
| NTC 备选，二选一 | 南京时恒 MF52B 103F3435-100 | [C394020](https://item.szlcsc.com/372739.html) | 1 只 | 14715 | 同样 10kΩ±1%、B25/85=3435 K±1%；100 mm 引线，本体最大约 Ø3×4 mm，体积较大 |

成品尾线图纸明确为 SH1.0 胶壳、单头镀锡，已对照 JST SH 原厂结构与主要尺寸；它们是韩下兼容品，并非 JST 原装，也未在用户板上实际试插。带凸缘宽约 2P 4.95 mm、5P 7.95 mm，需留侧向余量。

库存来自 LCSC 公开目录中的境内库存字段，是查询时快照。中文商品页本轮无法直接读取，因此给出对应 productId 链接和可直接搜索的 C 编号；中文商城实际可售状态、人民币价格、最小购买量以用户打开后的页面为准。本轮读取的国际目录两款尾线和两款 NTC 均按 5 件起售，细线组件按 1 件；不要把该起售量或美元价直接当作中文商城结算条件。

## 3. 细线怎么用

**C7496792 的 0.8 mm／8P 插头不能插后板。买它是为了取用内部细线，不是为了配套插头。**

1. 剪去两端 0.8 mm 插头，取其中 5 根完整细线；先备约 150～200 mm，实际试装后裁剪。
2. 后板 J401 仍使用上表的 **SH1.0 5P** 尾线；在后仓内将粗尾线分别焊接到这 5 根细线。
3. 接头错开放置，每芯独立绝缘并固定线根。只有细线段进入前筒；接头和外层总包覆不塞入窄槽。
4. 五根 0.38 mm 线并排名义宽约 1.9 mm，可作为现有 2.4 mm 线槽的备料选择；打印尺寸偏差和实际穿线仍需验证。商品未给出足够的导体股数信息，不把它表述为已验证的高柔性拖链线。
5. 0.38 mm 外径小于原厂 SSH 端子建议的 0.4 mm 下限，因此**不建议自行把它直接压进 SH 端子**；使用后仓焊接转线的方式。

也可让截图商家直接提供 AWG32、绝缘外径 0.40～0.45 mm 的 SH1.0 5P 成品尾线，这样可减少转接；这是定制规格，不能默认当前 0.08 mm² 商品已满足。

## 4. NTC 采购变化及接法

原说明中的 SEMITEC 103AT-4-040 未查到现货；同系列 103AT-4-050（C497233）本次库存为 0。上表提供的是**可采购替代候选**，没有偷偷改原电路或宣称充电温度验证已通过。

两款候选的 R25、B25/85 及公差与目标相符，但完整阻温曲线、热响应和外形不完全相同。绍鑫表中 0°C 为 27.280kΩ、60°C 为 3.02093kΩ；时恒分别为 27.513kΩ 和 3.030kΩ。最终采用哪一只，应记录到首件装配记录，并按原清单验证充电冷热截止和探头开短路处理。不要用普通 B3950 型号替换，也不要用固定 10kΩ 电阻冒充探头。

NTC 是两根漆包引线，不带 SH 插头。将可焊端焊到 **2P 尾线**，逐根绝缘，再插 **J103 / NTC**；NTC 无正负极。若剪短引线，需正确去漆并上锡，不能直接压接漆包线。探头绝缘贴附在成品电池外表面有空间的位置，给本体留余量，不靠后盖挤压电池，不拆电池保护板。焊接和热缩等热作业在探头贴到电池之前完成。

## 5. 原装插壳和端子：仅作备用，不与成品尾线重复购买

| 物品 | 型号 | 立创货号及链接 | 一支笔最低用量 |
|---|---|---|---:|
| JST 2P 无凸缘胶壳 | SHR-02V-S | [C398472](https://item.szlcsc.com/380810.html) | 3 |
| JST 5P 无凸缘胶壳 | SHR-05V-S | [C514174](https://item.szlcsc.com/529630.html) | 1 |
| JST 母接触压接端子 | SSH-003T-P0.2-H | [C263995](https://item.szlcsc.com/254752.html) | 11 |

这三项是散件，不含现成线束，需相应压接工具及工艺；为降低装配难度，当前优先成品尾线。SHR 胶壳不能单独使用。原装 JST ASSHSSH 系列预压线本次查到的 4 款均无现货，不列为现货推荐。

## 6. 没有在立创确认到合适现货的项目

- **PAT9125EL-TKIT 14×15 mm 成品光学板：**仍使用[此前确认的商品](https://item.taobao.com/item.htm?id=965101840300)，选 PAT9125EL-TKIT 五孔 I²C 模块。立创／器件库中同名 C2832657 是 LGA8 裸芯片，不能代替这块成品板。本轮未查到可确认替代的立创成品小板，也未核实淘宝实时库存。
- **笔尖开关已补充具体型号：**推荐首轮采用松下 EVQQ2B03W（C79178），详见第 9 节；有采购货号，尚未完成机械适配和书写实测。
- **指套和电池：**沿用现有成品；指套原 2.5 mm 插头直接接 J301，不需要再买一套音频头。电池使用原保护板输出线转接 J102。
- **USB 数据线及绝缘耗材：**已有可复用。USB-C 必须支持数据；焊点用细热缩管／薄绝缘胶带。这些通用品本轮未锁定具体立创货号。

因此，本轮已找到可查询货号的连接线、原装散件、细线材料和 NTC；**没有声称所有配件已在立创查齐**。

## 7. 接线速查

| 接口 | 电气针号及用途 |
|---|---|
| J102 / BAT | 1=电池正极，2=负极。不能只凭红黑线位置判断，接电池前测通断及极性 |
| J103 / NTC | 1=BAT_TS，2=GND；接两线 NTC，无极性 |
| J402 / TIP | 1=TIP_RAW，2=GND；接常开开关 NO/COM，无源触点 |
| J401 / OPT | 1=VDD，2=SCL，3=SDA，4=MOT，5=GND；逐线按信号名对应光学板 |

商品彩线顺序不等于电气顺序；尤其 2P 三个口外观相同，必须分别标 BAT、NTC、TIP。J401 的 VDD 名义为 3.45 V；成品模块供电及空闲电平的到货核对继续按[接线说明](接线与外购件说明_R26.md)执行。

## 8. 核对依据

- [查询记录与商品字段](shopping_r26/查询快照.json)，保留货号、productId、库存及产品资料地址。
- [韩下 2P 图纸](shopping_r26/C47018648.pdf)、[韩下 5P 图纸](shopping_r26/C47018651.pdf)。
- [JST SH 原厂手册](pcb/rear_mainboard/restore_esp32/j401_straight/research/lcsc_SM05B.pdf)，第 2 页列无凸缘与带凸缘壳体。
- [绍鑫 NTC 数据表](shopping_r26/C5439718.pdf)、[时恒 NTC 数据表](shopping_r26/C394020.pdf)。
- [XFCN 细线组件图纸](shopping_r26/C7496792.pdf)；0.38 mm 外径来自对应商品参数字段，非图纸标注。

## 9. 笔尖开关具体型号：EVQQ2B03W

根据用户“给一个型号”的要求，推荐 **Panasonic 松下 EVQQ2B03W，立创 C79178** 作为首轮实物验证选型，建议备 5 只。它是四脚、单刀常开、按下接通且松开回弹的轻触开关，用于原方案的落笔检测，不改为连续压力传感器。

| 参数 | 核对结果 |
|---|---|
| 外形 | 标称 6.5×6.0 mm，高 3.1±0.2 mm（含按钮）；引脚和焊线另留空间 |
| 动作力 | 标称 0.5 N，约 51 gf；这是开关轴向动作力，不等于装笔后的笔尖法向阈值 |
| 行程 | 系列规格表对 0.5 N 型列 0.2 mm；图纸页标题写系列短行程 0.25 mm，应以细分力档说明为准，不能把 0.2 mm 当作完整公差保证 |
| 寿命 | 厂商规定条件下 200 万次；不是整笔寿命承诺 |
| 接点 | A 与 A′内部同组，B 与 B′内部同组；选择 A 组一脚和 B 组一脚引出 |
| 电气接口 | 两根线接 J402-1 TIP_RAW 和 J402-2 GND，不分正反；按下读低。额定范围覆盖现有约 3.45 V、10 kΩ 上拉的输入用途 |

**现有打印件不能宣称直接兼容。**旧方腔横向约 6.4×6.4 mm，开关一边 6.5 mm，未计公差和焊线；旧模型的按钮高度、后端支撑、顶杆端面也不是按本型号制作。需要按器件图纸适配 **05／06 托架和 07 顶杆**，再检查外层前筒是否仍有足够壁厚与穿线空间；本轮没有修改或重新发布打印文件，也不保证只改方槽即可解决全部机械配合。

旧机构硬限位行程 0.25 mm，与开关名义 0.2 mm 只有 0.05 mm 差，不能忽略打印和器件公差。适配时必须保证松笔释放、落笔先闭合再碰塑料限位，重压由塑料止挡承力；不能靠拧紧笔头持续预压开关补偿。手感和轻笔画触发需要装样后实际验证，0.5 N 不等于“无感”已经成立。

本型号可用细线直接连接并由打印托架机械固定，不必为它单独制造 PCB；不能让焊点承担书写推力。四脚不要靠“同边／对角”口诀判断，以图纸 A/B 组和万用表确认静止断开、按下导通。厂商接点抖动上限为 10 ms，固件需要消抖，采集时间戳与状态确认时间分别记录。

依据：[本型号对应的松下系列数据表](shopping_r26/C79178.pdf)第 1、3 页，以及[2019 年系列表](shopping_r26/C713479.pdf)第 1、3 页。保留现有主控、后板接口和原理图。

## 10. 用户购物车核对与剩余备料（2026-10-29）

用户截图显示以下为购物车选项，**不是已付款或已到货记录**：

| 购物车项目 | 数量 | 核对结果 |
|---|---:|---|
| 松下 EVQQ2B03 开关 | 5 | 商品图标签为 EVQQ2B03W；购买完整型号应为 EVQQ2B03W，不能只按“6×6×3.1”选不同力度版本 |
| SEMITEC 103AT-4-050 | 2 | 可作为原 103AT-4 系列的 50 mm 引线版本采购，目标仍为 10kΩ±1%、B25/85=3435 K±1%；接2P尾线后连接J103。既然采购此型号，不必再买第2节的MF52替代候选 |
| SH兼容5P单头镀锡线，0.2 m | 5 | 一支笔用1根，现数量含较多备用；买2根也可。AWG28线径问题仍需按第3节处理 |
| SH兼容2P单头镀锡线，0.1 m | 5 | 一支笔用3根，数量足够并含备用 |
| PAT9125EL-TKIT成品模块 | 1 | 截图选项为PAT9125EL-TKIT模块，符合原选型；并非PAT9126JA或裸芯片 |

103AT-4-050在淘宝购物车中可选，与之前“立创本次库存为0”不矛盾；没有核实该淘宝商品的真伪、实时发货状态或实测参数。到货后仍按接线说明核对。

在后板（含JY901S）、成品电池与原指套均已具备的前提下，还需准备：

| 剩余物品 | 建议规格／数量 | 用途 |
|---|---|---|
| 光学段细线（已取消购买） | 历史备选：AWG32，单线绝缘外径约0.38～0.45 mm，5根各约0.2 m；按商家最小长度购买 | 在后仓与5P尾线转接，细线穿前筒。可使用第2节C7496792取线方案，不能把其0.8mm插头直接插后板 |
| 小热缩管 | 内径1.0及1.5 mm、2:1，各少量 | 每根焊线接头独立绝缘，接头留后仓 |
| 薄绝缘胶带 | 聚酰亚胺胶带，宽5～10 mm，一小卷 | 固定、绝缘NTC及线根；不是用胶带把探头隔空悬挂在电池旁 |
| 光学仓紧固件 | M2×6螺钉2颗＋M2螺母2颗；M1.6×3螺钉2颗，后者头径≤3.2 mm | 分别固定光学仓支架和仓盖；可各买5颗备用 |
| 柔软绝缘垫 | 电池底垫约0.5 mm；光学板边垫约0.25 mm，少量 | 按实际间隙使用，不顶压器件、镜头或电池 |
| USB-C数据线 | 1根，支持USB 2.0数据；电脑端接口匹配 | 充电和烧录，已有可用线不重复买 |
| 水笔芯 | 适配现有前筒的水笔芯及少量备用 | 已有不重复买；实际截短长度与顶杆间隙仍以装配为准 |

若后板尚未安装JY901S，应补齐此前确认的直接焊装裸模块；本轮不重新指定或替换型号。万用表用于断电通断／极性检查，已有则无需再购；也无需为了这批尾线另买胶壳、金属端子、压接钳或常规USB转串口烧录器。

机械待办保持：第9节EVQQ2B03W仍需适配05／06托架和07顶杆；购物车配齐不等于旧打印件已经可以直接装上该开关。

## 11. 不买细线，改壳适配成品尾线

用户决定不买额外光学细线，询问改壳可行性。评估结论：可行，保留SH1.0 5P成品尾线，从后板到光学模块直接接线，省去后仓内的粗细线焊接转接。模块端仍需焊接，后板端插头及J401线序不变。

已核对v0.4源模型：握持主体外径11 mm、内孔8 mm，普通壁厚约1.5 mm；既有光学线束包络只按0.5×2.4 mm设计。不能在旧槽上无限加深，否则会削弱筒壁；也不宜单纯把整个内孔扩大，侵占笔芯导向和结构强度。

建议后续模型在光学模块一侧布置较宽的走线通道，必要处向外局部加厚，优先维持握持主体11 mm尺寸。五根线平铺，入口和转弯采用圆滑过渡，保留线根固定位置，不能让线束摩擦笔芯或顶住开关机构。需连续检查光学仓出口、01前筒侧口和槽、05/06开关托架侧槽、03/04前后仓连接处，不能只扩大前筒中间一段。

商品标注的0.08 mm²是导体截面积，并未确定带皮外径。后续几何预留应根据单线最大外径、五线排布、打印公差和剩余壁厚确定；本轮不把猜测外径或通道尺寸冻结为最终制造尺寸。

可与EVQQ2B03W的05/06托架、07顶杆适配一并处理。本轮只更新采购决定和改壳要求，未生成或替换STL、STEP、3MF；不会要求重做后板。
