skxmxm/handWritePen/hardware/pcb/front_optical/research/pat9125_purchased_module/PAT9125EL_原厂摘要_用户提供.jpg

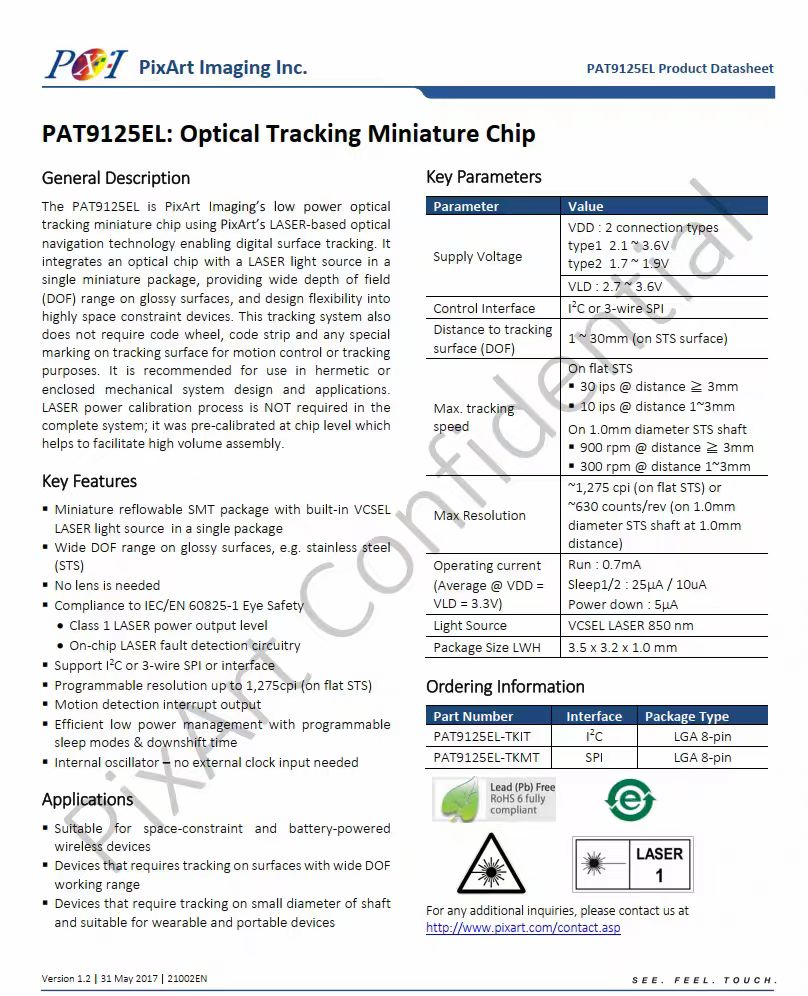
hardware/pcb/front_optical/research/pat9125_purchased_module/PAT9125EL_原厂摘要_用户提供.jpg
