skxmxm/handWritePen/mechanical/v0.5/cad/smart_pen_v05_assembly_mm.step

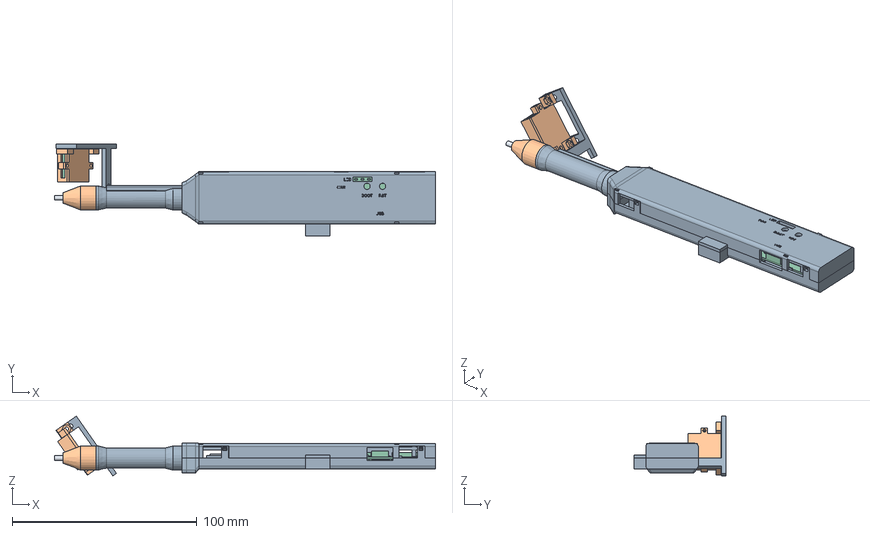
[picture p19: CAD file, 2026-11-06]
mechanical/v0.5/cad/smart_pen_v05_assembly_mm.step
206.0 x 49.6 x 32.3 mm
01_one_piece_barrel
02_threaded_nose
03_rear_base
04_press_release_cover
05_switch_carrier_lower
06_switch_carrier_upper
07_refill_plunger
08_optical_cassette
09_optical_lid
20_battery_dummy_36x12x6
21_PAT9125_dummy_14x15
22_rear_board_dummy_75x24
23_EVQQ2B03W_dummy
REF_gel_refill
REF_NTC_keepout
