skxmxm/handWritePen/mechanical/v0.5/cad/01_one_piece_barrel.step

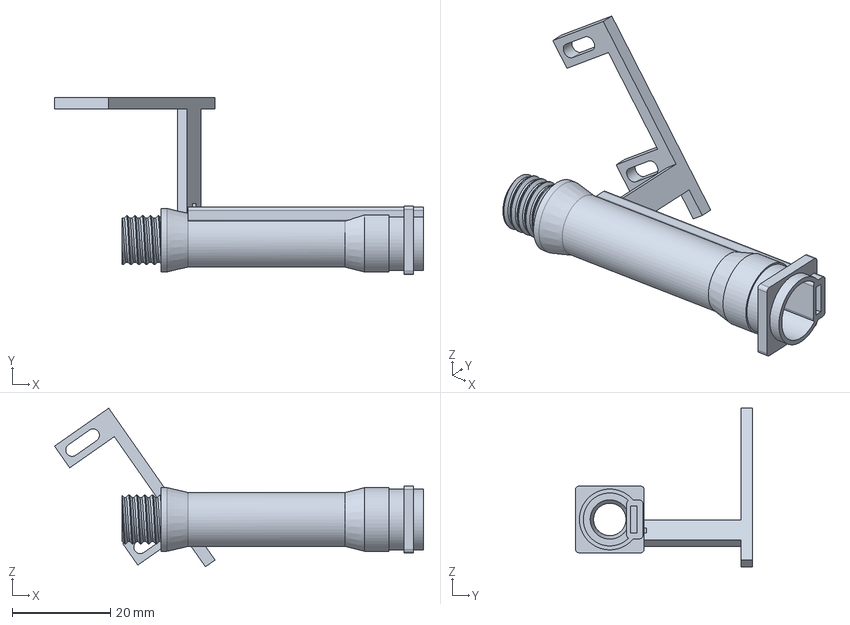
[picture p20: CAD file, 2026-11-06]
mechanical/v0.5/cad/01_one_piece_barrel.step
75.2 x 36.1 x 32.3 mm
