skxmxm/handWritePen/mechanical/v0.5/print_support_fix_20261030/02_后壳底座_P1S_PLA.3mf

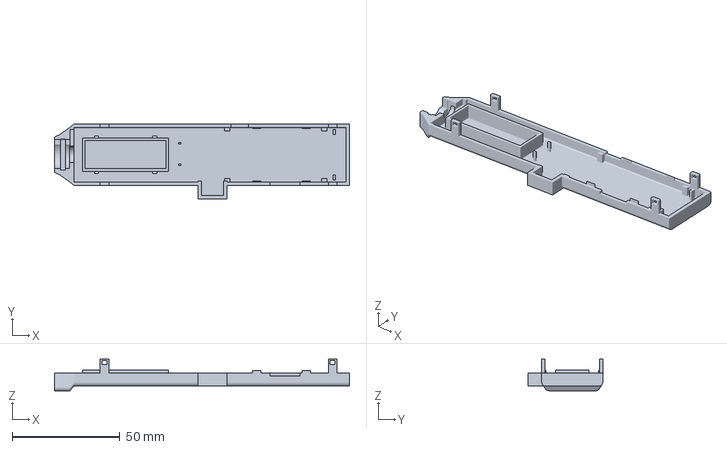
[picture p21: CAD file, 2026-11-06]
mechanical/v0.5/print_support_fix_20261030/02_后壳底座_P1S_PLA.3mf
137.0 x 34.7 x 14.6 mm
