skxmxm/handWritePen/mechanical/v0.5/refill_dummy_20261103/笔芯样件_67mm_尾端朝下.stl

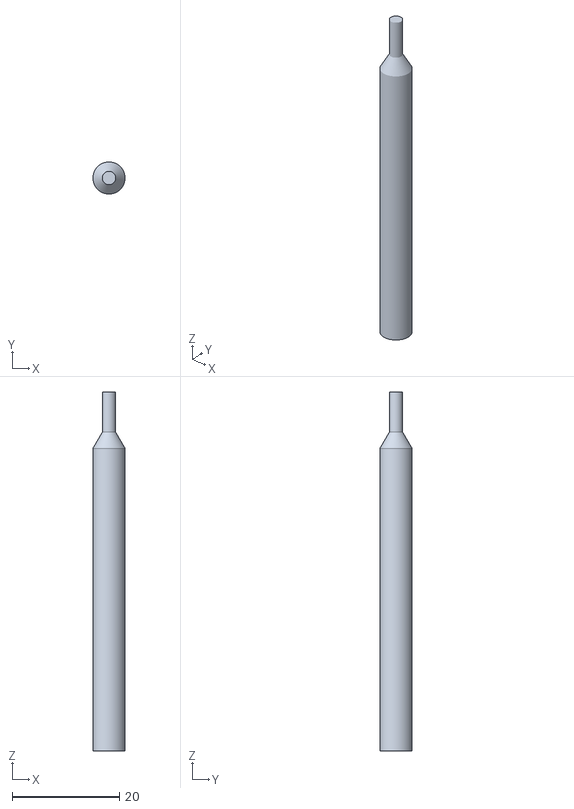
[picture p22: CAD file, 2026-11-06]
mechanical/v0.5/refill_dummy_20261103/笔芯样件_67mm_尾端朝下.stl
6.00 x 6.00 x 67.0
