skxmxm/handWritePen/mechanical/v0.5/cad/21_PAT9125_dummy_14x15.step

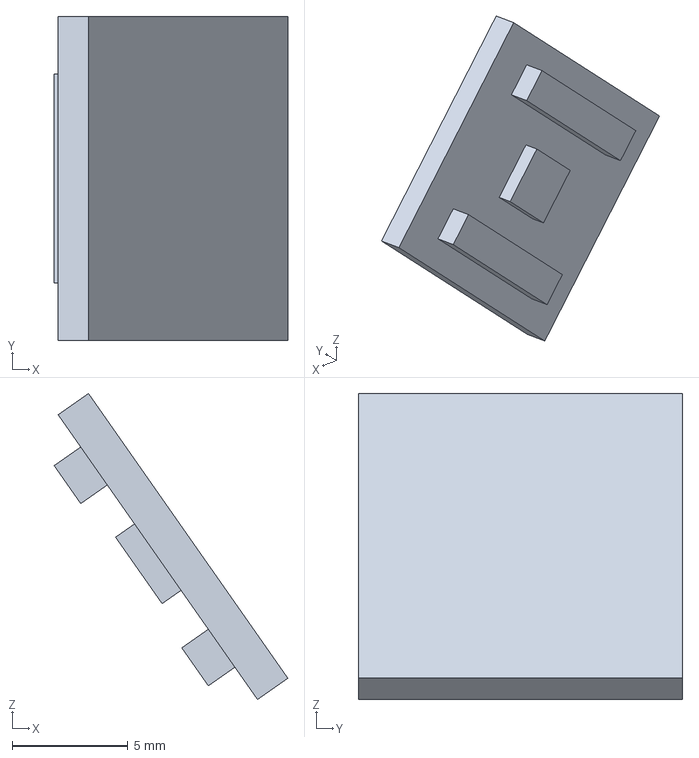
[picture p23: CAD file, 2026-11-06]
mechanical/v0.5/cad/21_PAT9125_dummy_14x15.step
10.1 x 14.0 x 13.2 mm
