skxmxm/handWritePen/mechanical/v0.5/print_support_fix_20261030/手写笔_v05_完整单盘15件_P1S_PLA_支撑修正版.3mf

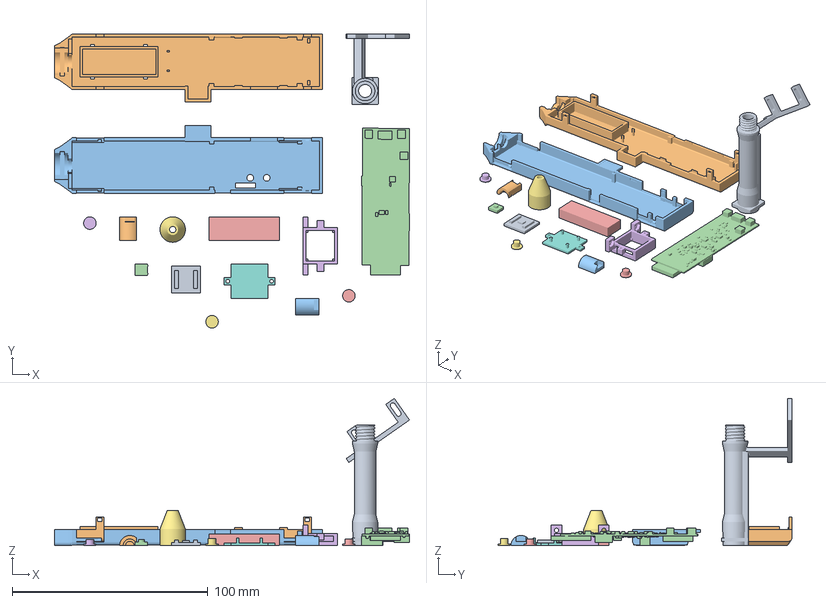
[picture p24: CAD file, 2026-11-06]
mechanical/v0.5/print_support_fix_20261030/手写笔_v05_完整单盘15件_P1S_PLA_支撑修正版.3mf
181.3 x 150.2 x 75.2 mm
01_one_piece_barrel
03_rear_base
04_press_release_cover
22_rear_board_dummy_75x24
20_battery_dummy_36x12x6
08_optical_cassette
02_threaded_nose
09_optical_lid
21_PAT9125_dummy_14x15
05_switch_carrier_lower
06_switch_carrier_upper
23_EVQQ2B03W_dummy
07_refill_plunger
10_plunger_short_3p2
11_plunger_long_3p6
