skxmxm/handWritePen/mechanical/v0.5/print_support_fix_20261030/01_先打_上盖验证_P1S_PLA.3mf

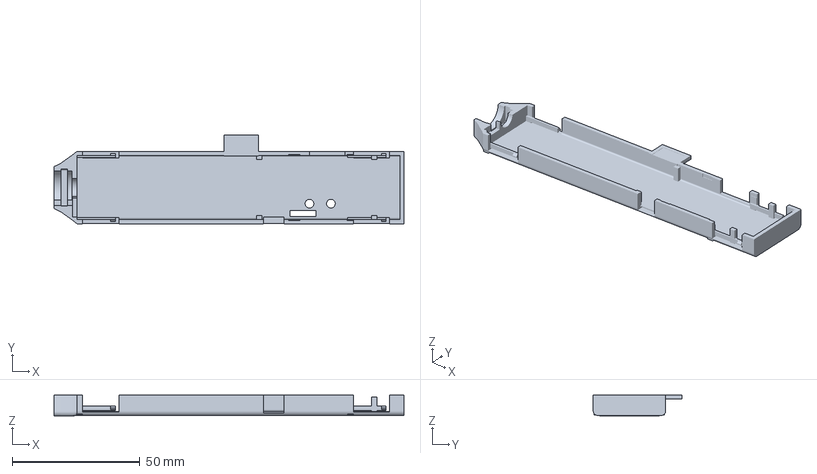
[picture p25: CAD file, 2026-11-06]
mechanical/v0.5/print_support_fix_20261030/01_先打_上盖验证_P1S_PLA.3mf
137.0 x 34.7 x 8.20 mm
