skxmxm/handWritePen/mechanical/v0.5/cad/05_switch_carrier_lower.step

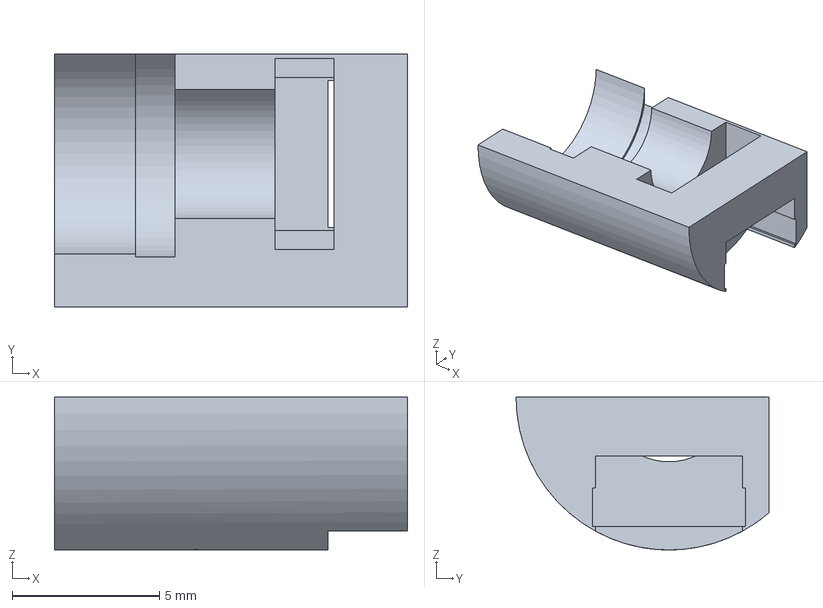
[picture p26: CAD file, 2026-11-06]
mechanical/v0.5/cad/05_switch_carrier_lower.step
12.0 x 8.60 x 5.20 mm
