skxmxm/handWritePen/mechanical/v0.5/cad/09_optical_lid.step

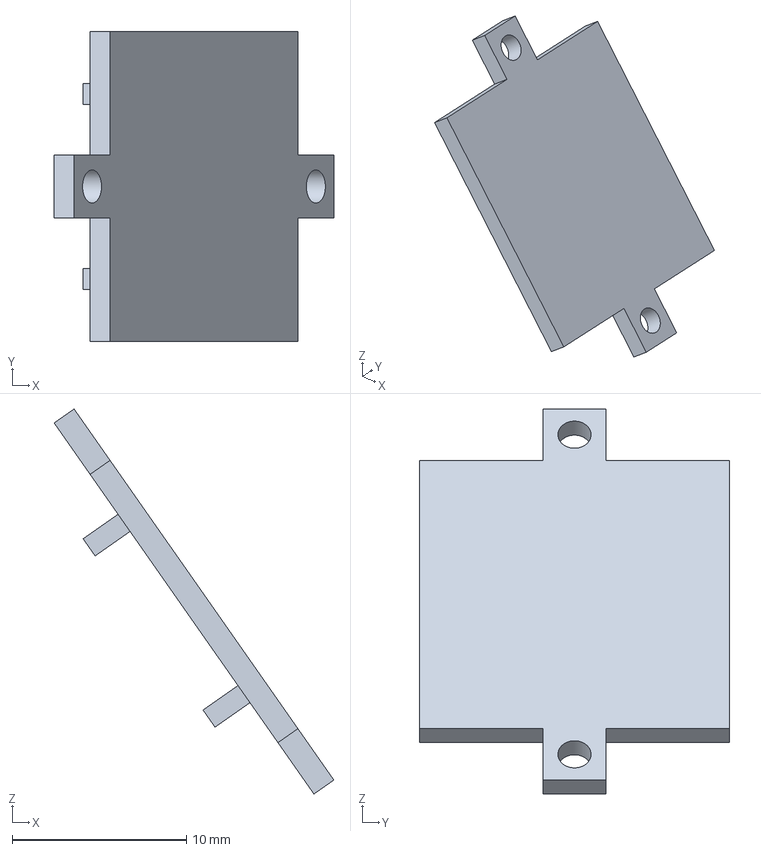
[picture p27: CAD file, 2026-11-06]
mechanical/v0.5/cad/09_optical_lid.step
16.1 x 17.8 x 22.1 mm
