skxmxm/handWritePen/mechanical/v0.5/cad/08_optical_cassette.step

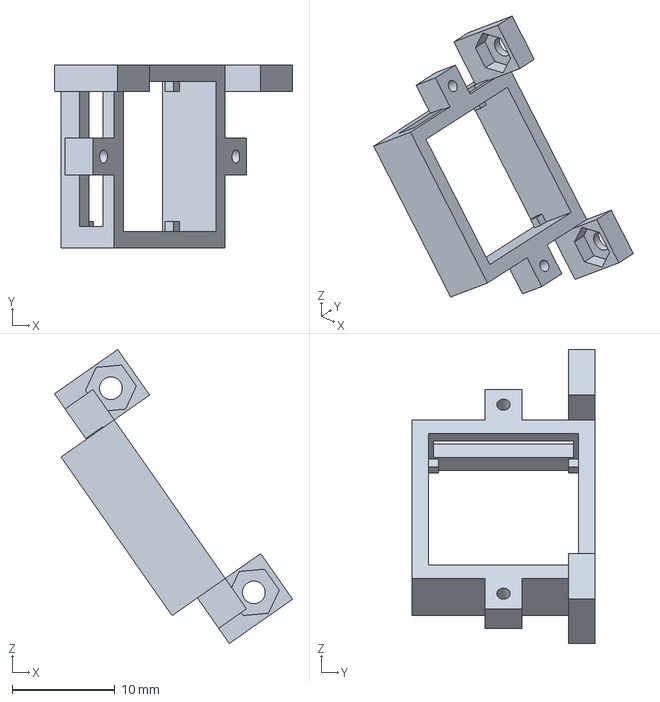
[picture p28: CAD file, 2026-11-06]
mechanical/v0.5/cad/08_optical_cassette.step
23.1 x 17.8 x 28.5 mm
