skxmxm/handWritePen/mechanical/v0.5/cad/23_EVQQ2B03W_dummy.step

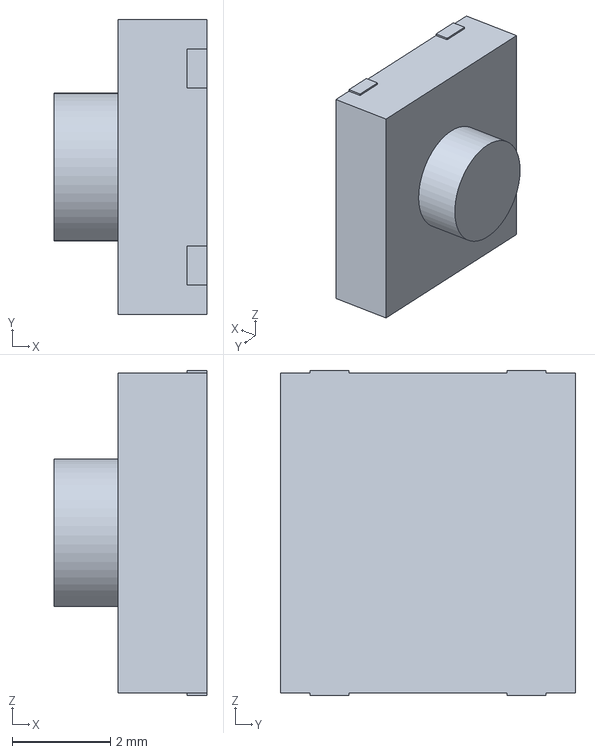
[picture p29: CAD file, 2026-11-06]
mechanical/v0.5/cad/23_EVQQ2B03W_dummy.step
3.10 x 6.00 x 6.60 mm
