skxmxm/handWritePen/mechanical/v0.5/cad/20_battery_dummy_36x12x6.step

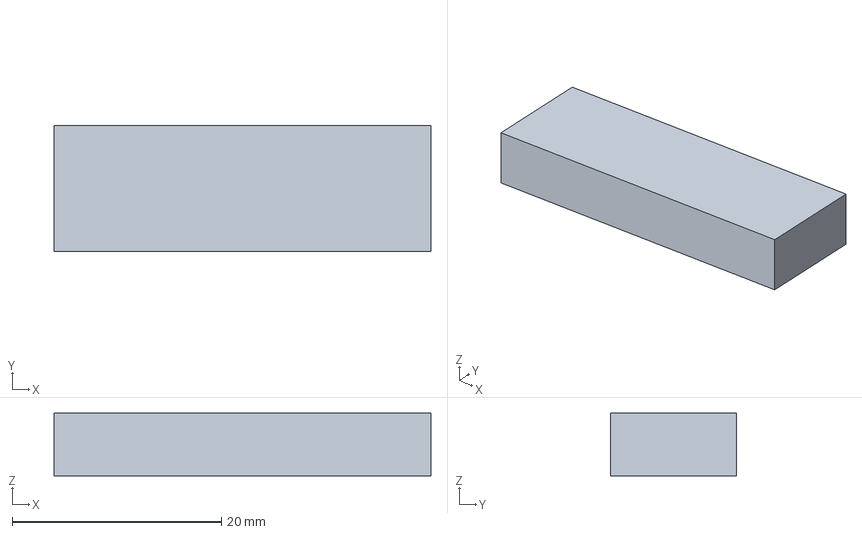
[picture p30: CAD file, 2026-11-06]
mechanical/v0.5/cad/20_battery_dummy_36x12x6.step
36.0 x 12.0 x 6.00 mm
