skxmxm/handWritePen/mechanical/v0.5/cad/22_rear_board_dummy_75x24.step

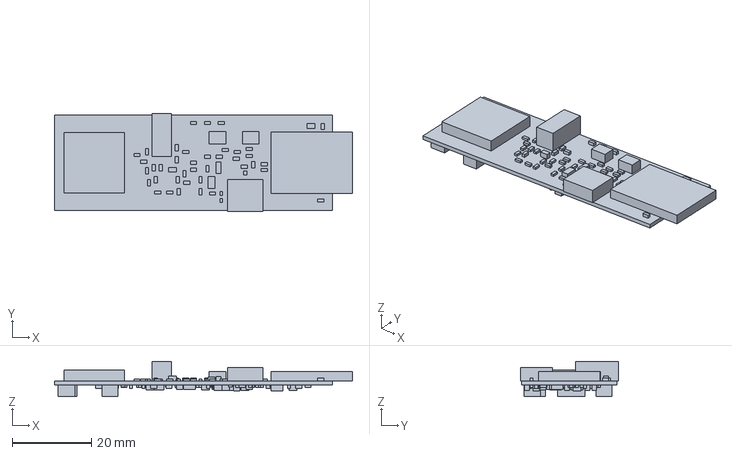
[picture p31: CAD file, 2026-11-06]
mechanical/v0.5/cad/22_rear_board_dummy_75x24.step
75.0 x 24.5 x 8.90 mm
