skxmxm/handWritePen/mechanical/v0.5/cad/07_refill_plunger.step

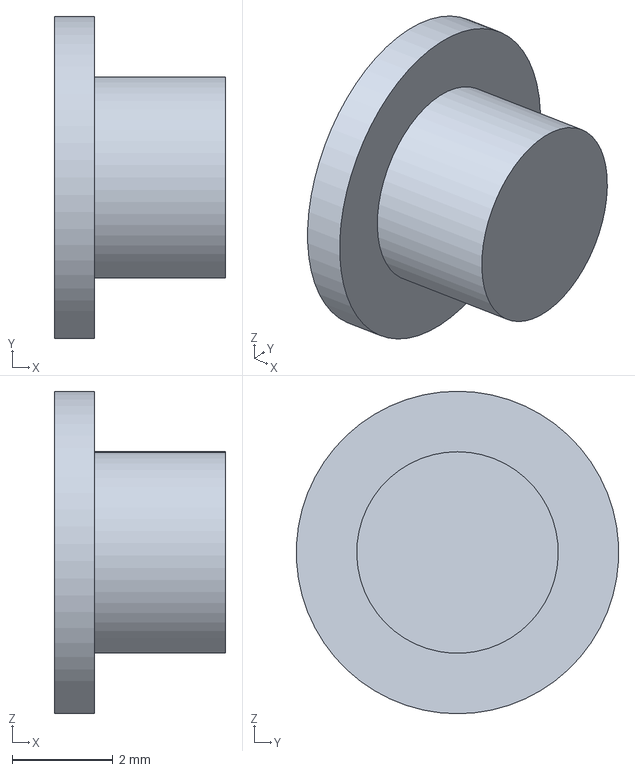
[picture p32: CAD file, 2026-11-06]
mechanical/v0.5/cad/07_refill_plunger.step
3.40 x 6.39 x 6.40 mm
