skxmxm/handWritePen/mechanical/v0.5/cad/reference_wire_route_NOT_FOR_PRINT.step

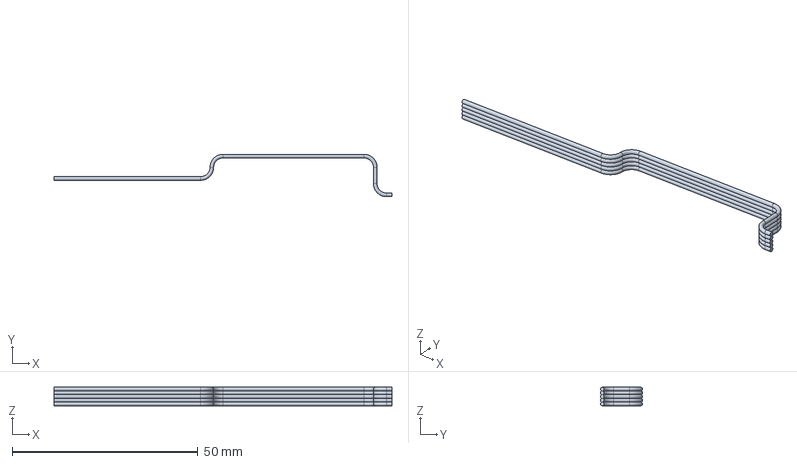
[picture p33: CAD file, 2026-11-06]
mechanical/v0.5/cad/reference_wire_route_NOT_FOR_PRINT.step
91.0 x 11.4 x 5.00 mm
