skxmxm/handWritePen/mechanical/v0.5/cad/10_plunger_short_3p2.step

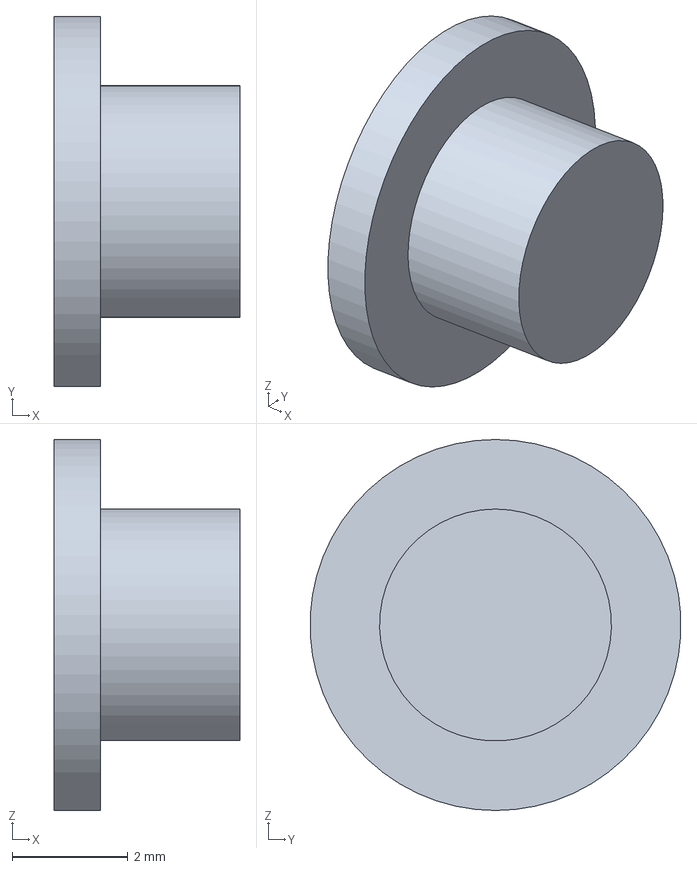
[picture p34: CAD file, 2026-11-06]
mechanical/v0.5/cad/10_plunger_short_3p2.step
3.20 x 6.39 x 6.40 mm
