skxmxm/handWritePen/mechanical/v0.5/cad/02_threaded_nose.step

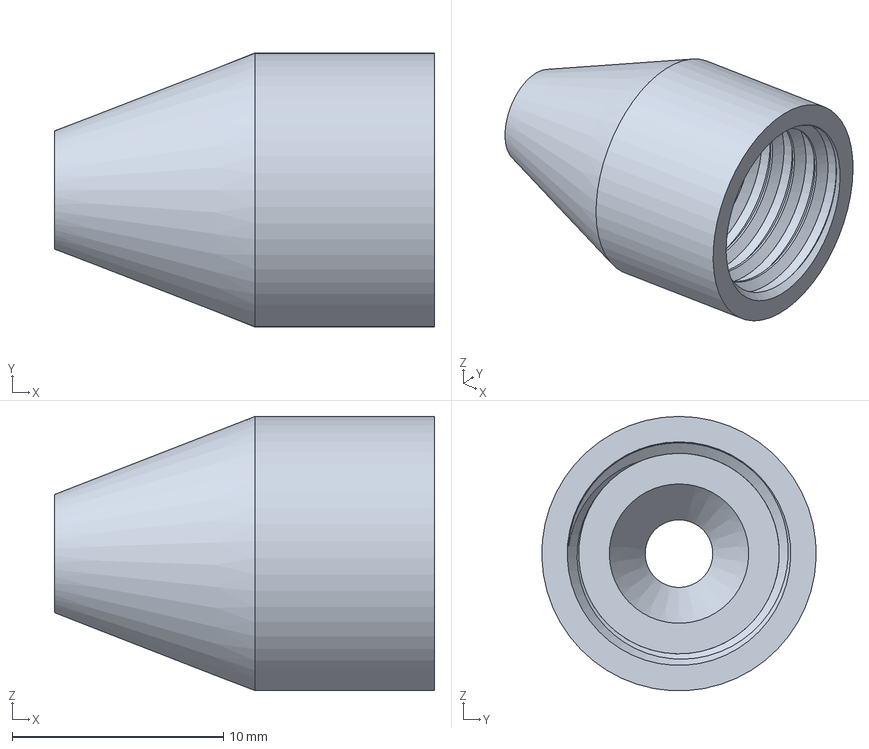
[picture p35: CAD file, 2026-11-06]
mechanical/v0.5/cad/02_threaded_nose.step
18.0 x 13.0 x 13.0 mm
