skxmxm/handWritePen/mechanical/v0.5/cad/11_plunger_long_3p6.step

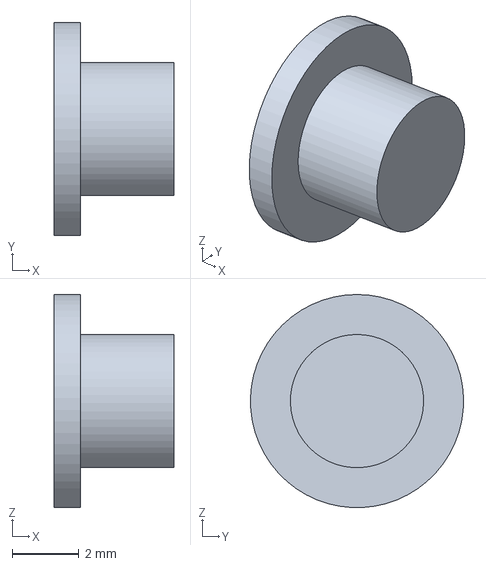
[picture p36: CAD file, 2026-11-06]
mechanical/v0.5/cad/11_plunger_long_3p6.step
3.60 x 6.40 x 6.40 mm
