skxmxm/handWritePen/(list of files, cad)

Other CAD files:
mechanical/v0.5/refill_dummy_20261103/笔芯样件_67mm_装配坐标.step
mechanical/v0.5/refill_dummy_20261103/refill_geometry_mm.3mf
mechanical/v0.5/refill_dummy_20261103/笔芯样件_67mm_P1S_PLA.3mf
mechanical/v0.5/cad/06_switch_carrier_upper.step
mechanical/v0.5/cad/04_press_release_cover.step
mechanical/v0.5/cad/03_rear_base.step
mechanical/v0.5/stl/01_one_piece_barrel.stl
mechanical/v0.5/stl/02_threaded_nose.stl
mechanical/v0.5/stl/03_rear_base.stl
mechanical/v0.5/stl/04_press_release_cover.stl
mechanical/v0.5/stl/05_switch_carrier_lower.stl
mechanical/v0.5/stl/06_switch_carrier_upper.stl
mechanical/v0.5/stl/07_refill_plunger.stl
mechanical/v0.5/stl/08_optical_cassette.stl
mechanical/v0.5/stl/09_optical_lid.stl
mechanical/v0.5/stl/10_plunger_short_3p2.stl
mechanical/v0.5/stl/11_plunger_long_3p6.stl
mechanical/v0.5/stl/20_battery_dummy_36x12x6.stl
mechanical/v0.5/stl/21_PAT9125_dummy_14x15.stl
mechanical/v0.5/stl/22_rear_board_dummy_75x24.stl
mechanical/v0.5/stl/23_EVQQ2B03W_dummy.stl
