skxmxm/handWritePen/hardware/rear_R26/制造与装配要求.md

# R26 后板制造与装配要求

当前源：R26，2026-10-09。工程已保存并重新导出，PCB和CAM检查通过。**原理图0 error，保留1项已审核的库属性提醒；旧参考器件的8个悬空脚已清理。本包为首批PCB＋SMT工程样板交付文件，厂方按下述工艺做DFM、备料及贴装预览核对；实物功能仍需首件验证。未下单。**

## 制板

- FR4、70×24 mm、4层、成品1.00 mm±10%，外层1 oz、内层0.5 oz，建议ENIG和绿色阻焊。
- 指定嘉立创JLC04101H-3313：外层到参考层介质0.0994 mm，芯板0.700 mm。不得直接替换为默认7628叠层。
- USB L1以L2 GND为参考，配对主干W/S=0.15/0.15 mm，90 Ω±10%，采用阻抗控制及测试条。官方标称计算87.785 Ω，同层地近邻计算85.551～87.837 Ω；生产叠层/工艺以此约束核对。
- 9个孔与器件阻焊开窗相交，见VIA_IN_PAD_PROCESS.csv，树脂填孔、整平、电镀盖帽；不能只用塞油/盖油。若厂商不支持选择性加工，可将全部231个过孔按同样工艺报价，但不得填连接器槽。
- 保留完整PTH中231个过孔、8个金属化槽，以及3个NPTH定位孔。重复via-only钻孔文件已经核对并去除。
- 铜、阻焊、钢网、保留钻孔、轮廓均与原生同版文件逐字节相同。本版丝印已在原生封装修正，与开窗最小间隙0.171978 mm；无需CAM裁切。只删除已确认重复的via-only钻孔文件。

## 装配

- 本轮移动11个底面器件，C302位于(28.80,−2.25) mm、R301绝对旋转270°；具体见R26装配说明，必须使用本版CPL，不能与R23/R23S坐标混用。自动SMT输入110件：BOM_FACTORY_SMT_110.csv / CPL_FACTORY_SMT_110.csv。
- 两件后焊：U401=JY901S裸模块、J301=SJ1-2503A指套插座。使用BOM_MANUAL_POST_REFLOW_2.csv / CPL_MANUAL_POST_REFLOW_2.csv；不混入机器贴片清单。
- U401在所有回流后手工焊装；未取得供应商回流曲线前，不将整个模块带入多次回流。焊盘保留预镀锡钢网开口，回流时不放模块；后续清理整平焊盘并手焊。不要超声清洗。
- J101为SMT信号脚加金属化外壳槽的混合连接器；工厂核对插装、壳脚焊接和钢网流程。未核对自动送料角度前不得按数字旋转盲贴。
- D501/D502/D503必须LTST-C190KRKT / C94869；顶视图pad1阴极朝左（较小X），pad2阳极朝右。旧Everlight底层器件名和旧Review字段由随包《原理图警告处理》明确覆盖，不能据其替料。
- U201必须ESP32-S3-MINI-1-N4R2，不能因历史封装名字含N8而换料。保持天线悬出及全层净空。双面SMT，按1脚/阴极及装配图核对方向；底层CPL不再人为镜像。
- 112 FIT总装参考文件包含上述110＋2；8件DNP、3组PCB_ONLY共37个焊盘无锡膏。默认钢网0.12 mm作为工厂评审输入，U101散热盘覆盖约86.05%。
- R111=59kΩ、R112=10kΩ，均0.1%、25ppm/°C；R104=5.1kΩ，名义充电58.8mA。精确料号和容差不得自动用同值普通料替换。实际库存与厂内封装匹配在备料阶段确认，本文未声称已经锁库。
- 工程含历史自制前板草案。此次只制造后板，前板采购PAT9125EL-TKIT，禁止把前板草案一起制板。

## 首件

USB ROM/UART烧录、BLE、真实电池瞬态及≥1h续航、NTC/充电保护、AFE标准电阻校准、光学纸面和装壳射频测试仍未实测。按随包上电清单进行；先使用合格限流台式电源，不接人体电极。新电芯的正式峰值/保护/温度参数未核实前，不用旧100mA规格替代，也不预先宣称整机合格。
