skxmxm/handWritePen/firmware/Tip_R26_Test/验证记录.md

# 微动测试程序验证记录

日期：2026-11-03。

- 依据当前R26接线资料：J402-1=TIP_RAW，R412 / 1 kΩ串联至GPIO11；R411 / 10 kΩ上拉；J402-2=GND；低电平为按下。SYS灯为GPIO12、高有效。
- 程序只读取无源常开开关，不要求光学模块或ADC通信成功。保持GSR_EN=GPIO7、CHG_EN=GPIO21、BAT_SENSE_EN=GPIO48低。
- 人工检查10 ms稳定状态消抖：输入每次翻转重置等待计时；确认状态改变后才递增相应计数；持续按住不重复计数；初始状态不计数。时间差使用无符号减法，适用于millis正常回绕。
- 本机实际编译通过：Arduino CLI 1.5.1、ESP32板包3.2.1-cn；FQBN为`esp32:esp32:esp32s3:USBMode=hwcdc,CDCOnBoot=cdc,FlashSize=4M,PSRAM=enabled,PartitionScheme=default`。
- 编译结果：程序326334 bytes（24%），全局变量20896 bytes（6%）。无需第三方库。
- 未上传用户设备、未实物按键测试；未验证接线、焊接、真实触点抖动或机械触发力。代码不测量压力值，串口也不提供精确触点边沿时间。
- 电池发烫故障未解决；本次继续使用USB，保持电池断开。没有改动PCB、GSR或光学测试源码。
