skxmxm/handWritePen/software/PenLive/reports/history/截至v059的验证记录.md

# R26 BLE 整笔程序验证记录

交付日期：2026-11-04。验证对象：本目录 Python 程序与 `../../firmware/Pen_R26_Live`。未上传设备、未修改 PCB、未下单。

## 当前 v0.59：无激励原始电压连续观察

- 用户明确改为“只展示不开激励的读数”，本轮不再要求继续测量/补焊。维护现有ESP32-S3、Arduino和Python目录，通过BLE传输，未改变PCB、充电设置、光学/IMU接线。
- 固件初始化将GPIO7设LOW，主循环在传感器/BLE操作前无条件保持LOW；按下/松开、断连、USB、重试均没有开启执行路径。不再调用GsrGate.tick，不发送EXC_ON或GSR_VALID，不执行350–700mV开启检查；不是放宽E08门限。旧GsrGate类保留作诊断结构与历史测试。
- ADS1115驱动未改变，A0/A1约10Hz新采样；增加RAW_OFF_MODE=4096和状态6，v3正文仍90字节。静止BLE目标20包/秒，活动目标50包/秒（小MTU25）。新版解码器拒绝“无激励模式同时带开启/有效电导标志”等矛盾包，旧上位机需同步更新。
- 界面连接后自动显示原始mV及曲线，不依赖微动，松开不清空，最多600条记录；保留负数、零值，按采样时间去重。ADC通信错误/过期显示横线、曲线留缺口；断连清空旧数据，恢复原始观察不要求再次按笔尖，也不会复活断连前尚未松开的旧笔画。
- VEX监测保留，关闭状态超过±50mV明确提示；FAULT灯仍涵盖光学、IMU、ADC和异常VEX，不以熄灯伪装全部硬件正常。原始值和新鲜ADC标志不证明模拟供电或生理信号有效。
- **63项Python测试通过**，新增10项覆盖原始模式分片/标志、C++包、负值、笔尖独立连续性、去重、ADC失效/过期/缺口、断连恢复、USB提示及无开启路径源码检查。包括既有轨迹、诊断与传输回归；见 `reports/python_tests.log`。
- **5组既有C++驱动/算法测试通过**，另新增真实C++原始包生成并由Python解码核对；测试使用MacOSX15.4 SDK。见 `reports/native_tests.log`、`reports/cpp_raw_off.hex`。
- **4组真实macOS Tk窗口检查通过**：raw_off_render_check、gui_smoke、pen_up_render_check、trace_render_check。覆盖无按压数值、松开连续曲线、ADC错误/过期、不跨缺口连线、VEX异常与USB文字、复制/清空按钮、断连、原有轨迹和旧固件兼容。修正测试样本中不合法的笔画号回退后通过。截图 `reports/无激励观察界面_模拟.png` 来自实际窗口，明确标为模拟数据。
- **Arduino编译通过：968,930字节程序，48,924字节静态RAM**。固件检查与上位机测试均未上传、连接或操控用户实板；BLE硬件和实际GPIO电平待实板验证，续航/真实采样精度未测。现存供电低压、VAA异常和冷启动问题未因本版修复。
- ADS1115、JY901S、光学、连续坐标及电池窗口驱动与v0.58备份比较未改；交付文件哈希见 `reports/release_sha256.json`。交付状态更正：v0.59源码验证后转入v0.60，未生成独立无激励ZIP，也未更新通用ZIP；v0.58归档存在。

以下为历史版本记录；其中开启激励、松开清空GSR、5Hz静止传输等不适用于当前无激励版。历史性能/截图保留作参考，本次未重新测量那些性能指标。当前编译日志和上述本轮测试日志已更新。

## 历史 v0.58：抬笔移动与跨笔画保留

- 固件不再在按下/松开时清零或丢弃光学位移，新增PenPosition连续坐标及溢出检查；光学轮询约100Hz，落笔/抬笔移动时目标50包/秒，小MTU25包/秒，抬笔静止后5包/秒。
- BLE主帧版本v3，正文仍为90字节加CRC；增加TIP_EDGE边界标志。新版Python解码v2/v3并拒绝混用版本的分片；旧固件仍为旧单笔行为且界面明确提示升级，旧上位机不支持v3。GSR和电池诊断特征不变。
- 轨迹页保留多笔，抬笔为空心移动光标，不添加移动连线；明确释放边界可收录末端，丢失边界时不把后续悬空位移画进笔画。新笔画编号即使遗漏开始/结束消息仍断笔。有效单点笔画保留为点。
- “清空轨迹”清除当前页面、以当前光标为新原点，不影响姿态、皮肤电采集状态和历史故障诊断。断连/超时/重启仍清空整页；姿态/GSR松开清空。默认反转Y保留。
- **53项Python测试通过**：其中12项新增连续坐标、两笔位置、抬笔不留线、释放末端、边界丢失、失效采样、清空归零、重启/断连、乱序及v3分片验证。其余覆盖原协议、连接、故障和电池窗口。
- **5组C++检查通过**：连续坐标及原子溢出拒绝、GSR、ADS1115、JY901S和电池窗口。原主数据、GSR及电池C++跨语言包生成器重新编译运行。当前本机默认SDK27与clang链接器不兼容，使用已安装MacOSX15.4 SDK通过原生测试；ESP32编译使用其独立工具链。
- **实际macOS Tk窗口检查通过**：v3分片解码到真实画布、抬笔位置变化但旧线对象/坐标不变、跨笔画间不连线、单点保留、光标与笔画统一翻转、实际按钮清空、断连隐藏；三窗口诊断、复制、电池显示与GSR松开行为也通过。报告见 `reports/pen_up_render_check.log`、`reports/trace_render_check.log`、`reports/gui_smoke.log`。
- 18,000点历史、5秒模拟50Hz输入，本机接收约50.05包/秒，界面约33.97次/秒；松开保留笔画通过。数字仅为此模拟窗口运行，不是实际BLE/显示器刷新或整机续航结果。见 `reports/refresh_smoke.json`。
- 最终Arduino编译通过：程序 **969,546字节**，静态RAM **48,924字节**。未烧录设备，真实抬笔位移取决于光学模块仍在有效工作距离；边界精度受10ms消抖、轮询和传输影响，未宣称无丢笔或笔尖位置已标定。GSR/E08与冷启动硬件问题仍未解决。

以下保留早期各轮验证记录；旧条目中的“松开清空轨迹”是v2行为，当前行为以上节为准。旧界面截图保留为历史示意。

## 固件编译

Arduino CLI 1.5.1，ESP32 核心 3.2.1-cn；目标 ESP32S3 Dev Module，USB Hardware CDC、CDC On Boot、4MB Flash、QSPI PSRAM、Huge APP 分区。

历史 v0.58 编译结果：程序 **969,546 字节 / 3,145,728 字节**；静态 RAM **48,924 字节 / 327,680 字节**。见 `reports/arduino_compile.log`。编译通过不等于实板功能已验证。

## 自动检查

- **41 项 Python 测试**：90 字节固件数据结构与 C++ 实际生成包对照、CRC16 已知向量、全部支持分片大小、逐字节损坏、丢片/重复/乱序/超时拒绝、松开包打断未完成数据、异常标志拒绝、两笔之间清空、序号回绕、断连清空、姿态过期、GSR 重复时间戳、充电状态解释、姿态矩阵、BLE 扫描/多设备歧义/订阅/重试命令，以及真实到达频率、批量到达、轨迹环形缓冲、积压数据过期。BLE 客户端为模拟，未接触真实外设。
- **C++ JY901S 解析检查**：校验和、错误帧恢复、截断/拼接、全部 65,536 个有符号角度码、加速度与角速度换算、复位。
- **C++ GSR 状态机检查**：关闭检查、开启稳定时间、每个状态下的 USB/微动释放/连接禁止、上下限故障、ADC 故障、数据超时、`millis()` 回绕。测试直接编译固件使用的 `GsrGate.h`。
- **C++ ADS1115 检查**：真实驱动使用模拟 I²C，核对 A0/A1、±4.096V、128SPS 配置字，完整成对提交、负数解码、NACK、配置读回不符、未完成转换超时与恢复。
- **macOS 原生 Tk 窗口检查**：三个窗口真实创建；模拟按下绘图、松开清空轨迹和姿态、皮肤电曲线清空、断连隐藏旧电压。检查深色系统主题下文字可读性，已改为固定浅色控件主题；降低画布默认高度以保留底部说明。

结果见 `reports/python_tests.log`、`reports/native_tests.log`、`reports/gui_smoke.log`。`reports/界面演示.png` 为模拟数据界面截图，不是硬件采集证据。

Python 复验：

```bash
.venv/bin/python -m unittest discover -s tests -v
.venv/bin/python tests/gui_smoke.py
```

C++ 测试位于 `tests`，使用 C++17。`ads_pair_test.cpp` 需要 `-I tests/mocks`；头文件路径以完整压缩包内目录结构为准。

## 尚需实板验证

1. 烧录、电池上电、BLE 广播与连接，按下/松开连续多轮行为。
2. PAT9125EL 模块实际工作距及纸面位移、JY901S 输出设置和安装轴向。
3. 电池电压与万用表对照；真实充电状态是否符合 STAT1/2。
4. 先用已知电阻检查 GSR / VEX，再判断指套采集；实际前端电气和硬件联锁不能由软件模拟替代。
5. 数据更新时间、BLE 丢包/重连、CPU 与射频耗电、续航和长时间稳定性。

当前 NTC 没有接入 ADC，无法通过这次软件提供电池温度数值。未实施皮肤电导/压力标定、光学毫米标定、笔尖倾角补偿或同步精度实测。

## 轨迹方向修正

根据使用反馈，默认勾选“反转Y”，相对初版上下翻转轨迹。该次方向修正通过 Python 语法检查；本轮增量绘图检查再次验证默认上下翻转。附图保留初版界面示意，当前频率计数栏以运行程序为准。

## 本轮高频版与微动灯更新

- 固件正常发送间隔从 50 ms 缩短至 20 ms，目标 50 包/秒；小 MTU 为 40 ms 目标 25 包/秒。请求 15 ms BLE 连接间隔，保持完整单包待发缓冲和分片发送，未绕过 GSR 检查或 USB 硬件联锁。
- SYS 灯直接跟随已消抖的微动状态；独立于 BLE 连接，按下亮、松开灭。代码明确由主循环统一写 GPIO12，不再由采集开始/结束函数改灯。实际亮灯仍需用户重烧录后检查。
- 轨迹分为最多 128 点的小段更新，保留原始数据及断线缺口，避免逐帧重建整条路径；缓存满后删除过期几何，缩放增加余量以降低全图跳动。
- 新增原生 Tk 检查：画线对象复用、默认上下翻转、丢包处断开、环形缓冲修剪、自动缩放边界、松开清空。报告为 `reports/trace_render_check.log`。
- 本机约 18,000 个历史点、固定缩放、每次追加一个点的 120 次比较：初版全量绘制平均 **28.48 ms**（P95 34.286 ms）；增量绘制平均 **7.97 ms**（P95 10.468 ms），含 Tk 延迟绘制处理。详见 `reports/trace_performance.json`。这是本机模拟绘图耗时，不是 BLE 实物性能。
- `tests/refresh_smoke.py` 使用后台模拟 50 Hz 数据源经过真实接收队列和三个 Tk 窗口，检查释放清空并记录实际调度频率；结果见 `reports/refresh_smoke.json`。最终本机前台约 18,000 历史点、5 秒模拟运行中，接收约 50.01 包/秒，界面调度约 28.61 次/秒，松开清空通过。目标 60 次/秒尚未在该长笔画整窗场景中达到，不作为已达成的硬件保证。

本轮执行了最终固件编译、24 项 Python 测试、三窗口模拟与增量渲染检查。未向设备烧录，真实 BLE 高频发送、电池续航与 SYS 灯亮灭等待用户上板验证。

## 本轮激励故障诊断（2026-11-04）

用户已运行此前版本并提供电池供电、VEX=0、GSR=1 mV、激励失败的截图。本轮未向实板烧录；根因仍未确认。此前版本的软件记录保留，下面为本次修改及检查。

- 固件在关掉激励前记录首次原因、阶段、VEX、ADC 错误及采样年龄；保持门限 ±50 mV / 350–700 mV、100/300 ms 检查稳定时间和 USB/释放/失联禁止不变。修正诊断记录中重复相同故障时笔画编号的更新判定。
- 新增独立 READ/NOTIFY 特征 `7c7b9004-8e77-4b62-9c3d-4d5d83f4a001`，20 字节含 CRC，适配最小 MTU=23；主 v2 协议保持不变。主数据仍是 90 字节正文加 2 字节 CRC。诊断正常每 200 ms 更新，新增故障及时发送。
- Python 总计 33 项测试通过，新增 C++ 真实故障包跨语言解码、故障电压保持、损坏拒绝、旧快照拒绝、重启/断开清理、旧固件兼容、诊断订阅或读取失败时主数据与控制仍继续。
- C++ 状态机测试增加精确边界、失败原因/阶段/电压/采样年龄、故障后 VEX 回零及松开不覆盖原故障；ADS1115 和 JY901S 既有检查再次通过。两个 C++ 包生成器产物分别为 reports/cpp_packet.hex 和 reports/cpp_diagnostic.hex。
- macOS 原生 Tk 检查通过：诊断文字及按钮实际可见、曲线仍有空间、松开保留历史、复制文本区分当前 0 mV 与故障时电压、主动断开清理。测试数据为模拟。未重跑无关的性能基准，前节数字保留为此前版本测量。
- 最终 Arduino 编译通过，968,674 字节程序、48,852 字节静态 RAM；软件和编译报告已更新。本次诊断的真实 BLE 收发及硬件故障原因仍需用户重烧录后确认。

排查步骤和已核对的 R26 VREF/VEX 测试点见[激励故障排查](../../激励故障排查.md)。没有更改 PCB、降低检查标准或绕过硬件联锁。

## 电池压降诊断更新（2026-11-04）

用户提出可能电池电压不足，希望从代码降低激励。现板没有可编程激励DAC，GPIO7只能开关，因此未把降低报错门限冒充降低电压。本轮新增被动电池观察，保持GsrGate.h、AdsPair.h和BlePacket.h与此前诊断发布版逐字节一致，未延长激励或改变门限。

- BLE主数据订阅后分压常开，150ms稳定后目标每50ms采样8次平均。原有电池主数据显示约1Hz；连续分压额外直流负载约VBAT/660kΩ（4.2V时约6.4µA），实际整机功耗未实测。
- 以软件激励命令开启/关闭为窗口；开前电池样本须≤100ms，之后只接受窗口内的新采样。结束后保留，重试新窗口重置。采样计数255封顶，最低值继续更新。电池下降至原显示有效范围外（如2.1V）的原始换算值仍被诊断记录，不因显示有效性门限丢掉低值。
- 新增独立20字节READ/NOTIFY特征7c7b9005-8e77-4b62-9c3d-4d5d83f4a001，原主数据和故障特征不变。上位机缓存最近8个窗口，严格按boot/stroke匹配历史故障；缺失、旧固件、读取失败均明示。晚到的读取不覆盖已完成窗口或更低值。
- 41项Python测试通过，包括C++电池快照跨语言核验、CRC及非法状态拒绝、匹配旧故障、晚到/错启动数据拒绝、重启/断开清理、缺失数据不冒充0V、旧固件兼容与可选订阅。
- C++新增BatteryWindow测试：开前采样年龄、排除开启前样本、重复/过期过滤、最低值保留、释放、深度掉压、计数饱和、时钟回绕；既有GSR门限/联锁、ADS1115和JY901S测试再次通过。
- 真实macOS Tk三窗口测试通过：电池窗口文字可见、复制诊断包含匹配电池值及差值、故障历史与当前读数分离、曲线仍有显示空间。数据均为模拟。
- 最终Arduino编译通过：程序969,470字节，静态RAM48,916字节。未上传用户设备、未做本版实物BLE或压降测试；未重跑无关性能基准。

限制：VBAT采样经过约16.5ms RC滤波、约50ms调度间隔和8次平均，不捕获所有短瞬态；MCU掉电/重启可能丢失未发送窗口。没有3V45/VAA监测输入，因此电池值正常不能排除下游电源故障。
