skxmxm/handWritePen/hardware/shopping_r26/C47018648.pdf

线型：

1571 28#

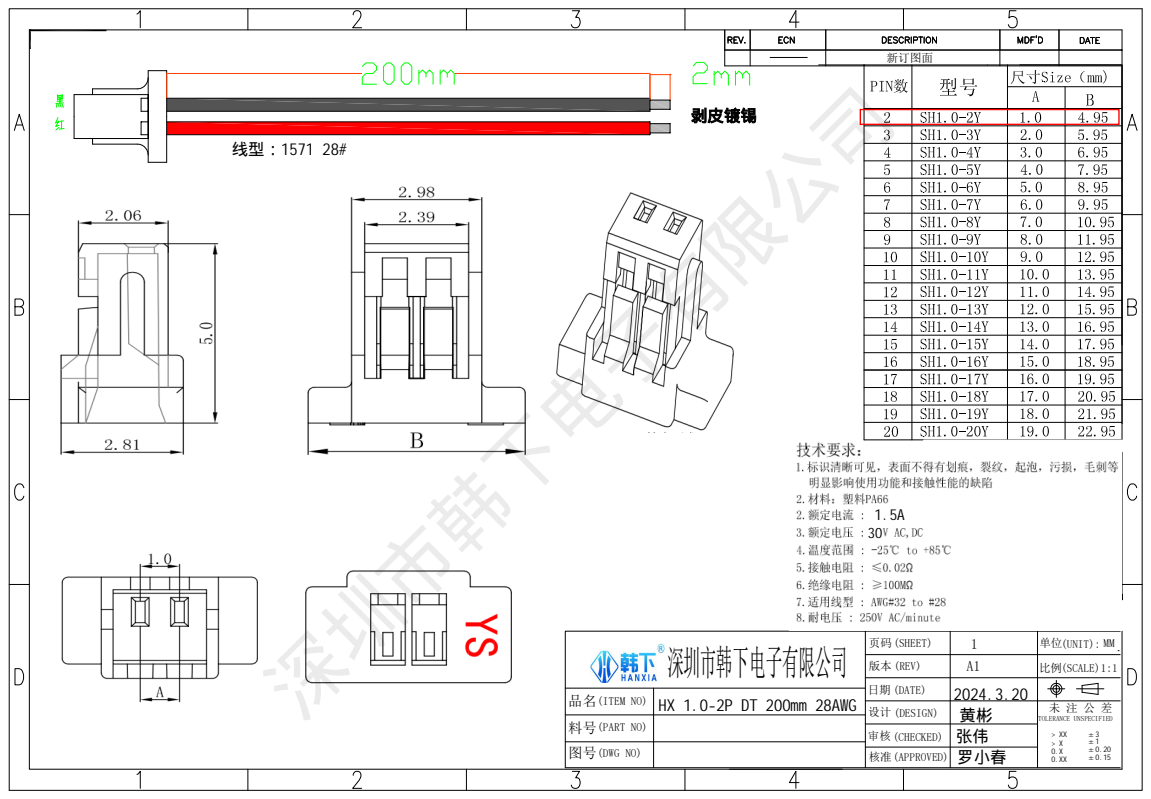
[picture p49: page 1]
新订图面; TOLERANCE UNSPECIFIED; (UNIT): MM; 比例(SCALE)1:1; 版本 (REV); (DESIGN); (CHECKED); (APPROVED); (DATE); (SHEET); 1 深圳市韩下电子有限公司; 2024.3.20 黄彬 张伟 罗小春

深圳市韩下电子有限公司 HX 1.0-2P DT 200mm 28AWG ±3 ±1 ±0.20 ±0.15 剥皮镀锡 1.5A 30

品名(ITEM NO)

料号(PART NO)
(DWG NO)
