skxmxm/handWritePen/hardware/shopping_r26/C47018651.pdf

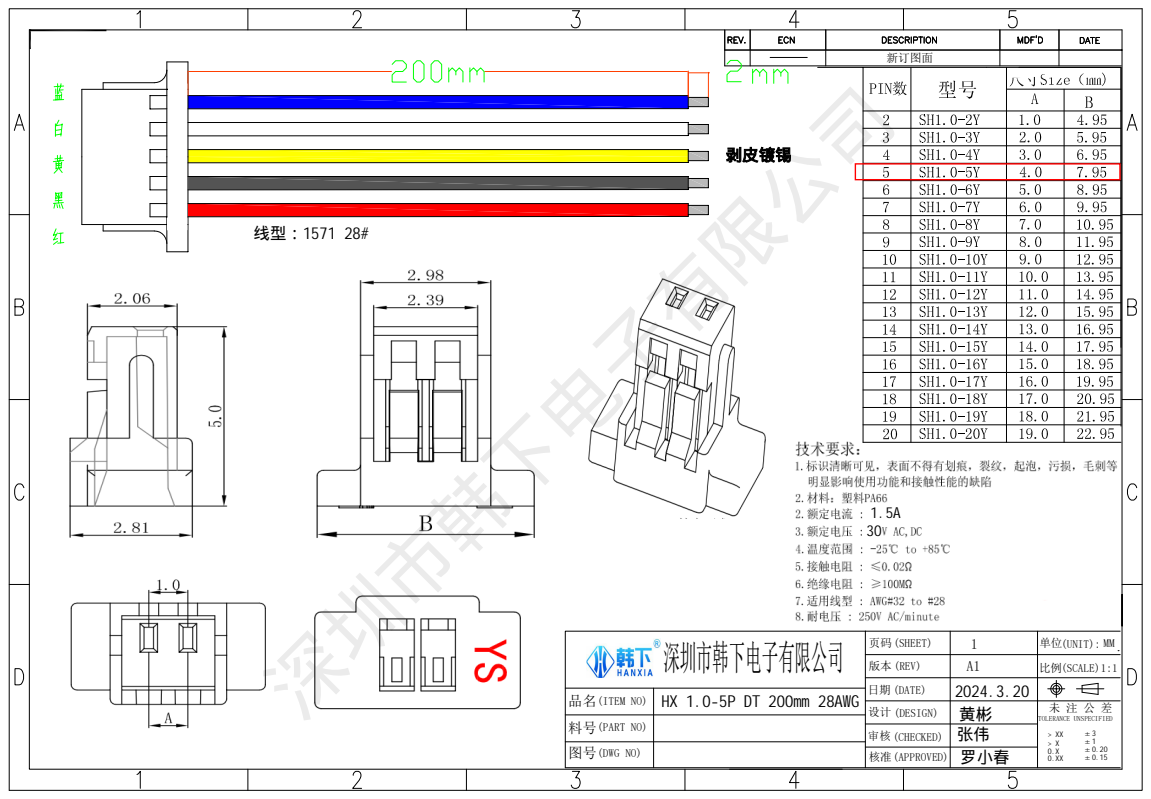
[picture p50: page 1]
新订图面; TOLERANCE UNSPECIFIED; (UNIT): MM; 比例(SCALE)1:1; 版本 (REV); (DESIGN); (CHECKED); (APPROVED); (DATE); (SHEET); 1 深圳市韩下电子有限公司; 张伟 罗小春; 深圳市韩下电子有限公司 m 28AWG ±3 ±1 ±0.20 ±0.15 剥皮镀锡 1.5A 30

品名(ITEM NO)

料号(PART NO)
(DWG NO)
