skxmxm/handWritePen/(list of files, drawings)

Other design files:
hardware/rear_R26/PCB_DRC.json
hardware/rear_R26/Rear_ESP32S3_R26.epro
